claust/robot_3d/shared/RobotLink/README.md

# RobotLink

The Bluetooth side of the robot car remote ([ios/RobotRemote](../../ios/RobotRemote)):

| | |
|---|---|
| `DriveProtocol` | the GATT contract with [pi/robot_car/remote.py](../../pi/robot_car/remote.py): UUIDs, rate, the 4-byte command |
| `WheelSpeeds` | signed wheel speeds, and `arcade(x:y:)`, the one-thumb stick-to-wheels mix |
| `DrivePattern` | the preset square, circle and eight as timed wheel commands, from the car's track and a fitted command-to-speed model, with a correction per kind of move |
| `CarLink` | what the UI holds: the link's state and signal strength, `wheels` and `cutter` to set, which only count while connected, and `drive(_:)` to play a pattern until it ends, is stopped, the wheels are set by hand or the link drops; `simulated` for the iOS Simulator |
| `LinkMachine` | the connection logic as a pure state machine: scan, connect, find the drive service, time out, search again (internal) |
| `Radio` | CoreBluetooth on its own serial queue, running `LinkMachine`'s effects and the 20 Hz command stream off the main thread (internal) |

No UI, and declared for macOS 14 as well as iOS 17, so the mix, the
encoding, the patterns and the connection logic are unit-tested on the Mac.
The pattern tests run each pattern through the timing's own model and check
the path in centimetres:

```sh
swift test --package-path shared/RobotLink
```
