claust/robot_3d/ios/RobotRemote/README.md

# Robot Remote (iOS)

Drives the robot car from an iPhone over Bluetooth LE, one thumb on a
floating stick. Wherever the thumb lands in the bottom panel becomes the
centre. Up drives both wheels forward, down both back, sideways spins the car
on the spot, and anything between is an arc. Lifting the thumb stops the car,
and so does losing the link: after a reconnect the car waits for the thumb to
move again rather than resuming the old command.
The two bars show what each wheel is being told, and "Top speed" caps both.

## Patterns

Above the stick, three buttons drive a preset route on their own: **Square**
(40 cm sides, turning left on the spot at each corner), **Circle** (40 cm
across, to the left) and **Eight** (a 40 cm loop to the left, a short pause,
then one to the right, meeting where the car started). Each ends where it
began. Give it a clear patch of floor about a metre across, with the car in
the middle. While a pattern runs, the row shows its progress and a Stop button.
Dragging the stick also takes over. Losing the link ends the pattern, and it
doesn't resume after a reconnect. Patterns run at their own fixed speeds,
whatever "Top speed" says, so a calibration stays valid.

The car has no wheel sensors, so the app times each move from the car's
geometry and a model of how fast a wheel rolls for a given command. Any
command lifts the motors to their 25 % starting duty, which already rolls
the car at about a third of its top speed, so the model has a floor and the
circle's inner wheel gets less than its share of the command. The slider
button next to the patterns corrects the model, one setting per kind of
move:

- **Straight**: if the square's sides come out at 36 cm instead of 40,
  raise it to about 40 / 36 = 111 %.
- **Corners**: lower it if the corners turn more than 90°, raise it if less.
- **Circle size**: lower it if the circle comes out wider than 40 cm. It
  changes the wheels' speeds, not the time, and usually fixes how far round
  the circle goes as well, so set it first.
- **Circle length**: raise it if the circle then stops short of where it
  started, lower it if it goes past.

Expect a few degrees of scatter from run to run: each command reaches the
car on the next 20 Hz tick, and some arrive a tick late over Bluetooth. The
timing is in `DrivePattern` in [shared/RobotLink](../../shared/RobotLink).

The first time, switch the car on and open the app within two minutes:
iOS asks to pair, and you tap Pair. The car only takes commands from a
paired phone, and only pairs new phones just after power-on. See
[Pairing a phone](../../pi/robot_car/README.md#pairing-a-phone).

With VoiceOver, Voice Control or Switch Control the stick is one
adjustable control named Drive. Swipe up or down to step the speed by a
quarter, use its actions to turn left, turn right, go straight or stop,
or stop with the escape or magic-tap gesture. That command holds until it
is changed, and stops when the app leaves the screen.

The app connects to the first car advertising the drive service and goes
back to scanning when the link drops. When the app leaves the screen it lets
go of the car. It keeps the screen awake while connected. The Bluetooth
logic is in [shared/RobotLink](../../shared/RobotLink). The car's end,
including the 300 ms watchdog that stops the wheels when the phone goes
quiet, is [pi/robot_car/remote.py](../../pi/robot_car/remote.py).

## Build and install on the phone

The Simulator has no Bluetooth, so the real thing needs the phone, plugged in
or on the same network with developer mode on. Requires Xcode and
[XcodeGen](https://github.com/yonaskolb/XcodeGen); the `.xcodeproj` is
generated, not committed. `xcrun devicectl list devices` gives the phone's
identifier.

```sh
xcodegen generate
xcodebuild -project RobotRemote.xcodeproj -scheme RobotRemote \
  -destination "id=$PHONE" -derivedDataPath build \
  -allowProvisioningUpdates DEVELOPMENT_TEAM=$TEAM build
xcrun devicectl device install app --device "$PHONE" build/Build/Products/Debug-iphoneos/RobotRemote.app
xcrun devicectl device process launch --device "$PHONE" dk.delectosoft.robotremote
```

The first launch asks for Bluetooth permission.

## Simulator

In the Simulator the app drives a simulated car, which connects after a
moment and shows the stick and wheel bars working. Launching on the phone
with `--simulate` does the same.

```sh
xcodebuild -project RobotRemote.xcodeproj -scheme RobotRemote \
  -sdk iphonesimulator -destination 'name=iPhone 17 Pro' \
  -derivedDataPath build build
xcrun simctl install booted build/Build/Products/Debug-iphonesimulator/RobotRemote.app
xcrun simctl launch booted dk.delectosoft.robotremote
```
