claust/robot_3d/shared/BambuKit/README.md

# BambuKit

The protocol layer both status apps build on — the macOS window app
(`macos/PrinterStatus`) and its iPhone sibling (`ios/PrinterStatus`) each
depend on this package, so a protocol fix lands in both at once.

| | |
|---|---|
| `BambuMQTTSource` | LAN MQTT session: subscribe, `pushall`, reconnect forever |
| `BambuTrust` | Bambu's device-CA roots, vendored from Bambu Studio (internal) |
| `BambuCameraSource` | chamber camera: RTSPS → H.264 → VideoToolbox, emitting `CGImage` |
| `BambuDeviceCA` | harvests the intermediate CA the camera port omits |
| `PrinterSnapshot` | tolerant decode of one `print` report, plus `deepMerge` |
| `PrinterConfig` | the three credentials; each app resolves them its own way |
| `PrinterDiscovery` / `DiscoveredPrinter` | find printers on the LAN by unicast M-SEARCH sweep; the `SSDP` wire format and probe behind it are internal |
| `PrinterNameSource` | the single-host case: the friendly name for a known IP |
| `SimulatedSource` | fake reports in the printer's own schema |

No UI. The package is declared for both macOS 14 and iOS 17, so an
accidental `import AppKit` fails here rather than in one app's build. That is
also why the camera emits `CGImage` rather than `NSImage`/`UIImage`.

RTSP comes from [claust/IPCamKit](https://github.com/claust/IPCamKit), our
fork of [steelbrain/IPCamKit](https://github.com/steelbrain/IPCamKit) (MIT),
pinned by revision. The fork exists for two patches upstream lacks — TLS, and
a Digest quirk that Bambu's LIVE555 server rejects — both described in that
repo's `PATCHES.md`.

```sh
swift build --package-path shared/BambuKit
swift test --package-path shared/BambuKit   # SSDP parsing + subnet arithmetic
```

Discovery notes, including why it sweeps unicast instead of listening for
Bambu's broadcasts, are in [../../macos/RESEARCH.md](../../macos/RESEARCH.md)
and the doc comment on `PrinterDiscovery`.
