claust/robot_3d/macos/RESEARCH.md

# Printer status data — research notes

What the Bambu Lab X2D exposes over the LAN, measured live against our printer
(2026-08-26, firmware ota 01.02.00.00, mid-print of `fit_test_02`) plus the
community docs (OpenBambuAPI, ha-bambulab/pybambu).

## Transport

- MQTT over TLS on port 8883, user `bblp` + LAN access code (same credentials
  as `cad/.env`). The printer's certificate is not publicly trusted: it
  chains to Bambu's own device CA (root shipped with Bambu Studio, vendored
  in `PrinterStatus/Sources/PrinterStatus/BambuTrust.swift`), and names the
  printer's serial rather than its IP.
- Subscribe to `device/<SERIAL>/report`. After one
  `{"pushing": {"command": "pushall"}}` request the X2D pushes a **full ~99-key
  report about once per second while printing** — no polling loop needed.
  When idle the push rate drops; send a `pushall` on reconnect and every few
  minutes as a keepalive refresh.
- Same MQTT channel accepts commands (`device/<SERIAL>/request`): pause /
  resume / stop, speed level, lights, target temps, AMS ops.

## Available fields (measured — `print.*` unless noted)

### Job & progress
| Field | Example | Meaning |
|---|---|---|
| `gcode_state` | `RUNNING` | IDLE / INIT / PREPARE / SLICING / RUNNING / PAUSE / FINISH / FAILED / OFFLINE |
| `subtask_name` | `fit_test_02` | job name |
| `gcode_file` | `/data/Metadata/plate_1.gcode` | file being printed |
| `mc_percent` | `92` | progress % |
| `layer_num` / `total_layer_num` | `37` / `45` | current / total layer |
| `mc_remaining_time` | `0` | minutes remaining |
| `mc_print_stage`, `stg_cur` | `2`, `0` | stage codes — `stg_cur`: 0 printing, 1 bed leveling, 2 bed preheat, 7 heating hotend, 10 first-layer inspect, 13 homing, 16 paused-by-user, 24 filament loading … (pybambu const.py `CURRENT_STAGE_IDS`; -1/255 = idle) |
| `print_error`, `mc_print_error_code` | `0` | error codes |
| `hms` | `[{attr, code, …}]` | active HMS health warnings; hex words of attr+code form the wiki code, e.g. `wiki.bambulab.com/en/x1/troubleshooting/hmscode/0300_0100_0001_0007` |

### Temperatures
| Field | Example | Meaning |
|---|---|---|
| `nozzle_temper` / `nozzle_target_temper` | `220.0` / `220.0` | **active** nozzle |
| `bed_temper` / `bed_target_temper` | `55.0` / `55.0` | bed |
| `device.extruder.info[i].temp` | `14418140` | per-nozzle, bit-packed: low 16 bits = current, high 16 = target (14418140 = 220/220 °C) |
| `device.bed.info.temp` | `3604535` | packed the same way (55/55 °C) |
| `device.ctc.info.temp` | `32` | chamber, packed the same way (heater off → target 0) |

The packed `device.*` fields are the only place both nozzles appear; the flat
`nozzle_temper` tracks whichever nozzle is active. Per pybambu: extruder
**id 0 = right, id 1 = left**; the active extruder index is
`(device.extruder.state >> 4) & 0xF` (low 4 bits = extruder count). Our
capture: `state = 0x8112` → 2 extruders, left one active at 220 °C while the
right sat at 41 °C. `info[i].snow` says which AMS slot feeds each nozzle
(low bits = tray, `>>8` = AMS unit; 255 = none, 254 = external spool).
If `device` is absent (older firmware), fall back to the flat fields.

### Fans, speed, environment
- `cooling_fan_speed`, `big_fan1_speed` (aux), `big_fan2_speed` (chamber),
  `heatbreak_fan_speed` — raw 0–15 PWM as strings; percent ≈ `v * 100 / 15`.
- `device.airduct.parts[]` — X2D's real fan/airduct percentages (`state`/`tar_state`).
- `spd_lvl` (1 silent / 2 standard / 3 sport / 4 ludicrous), `spd_mag` (%).
- `wifi_signal` (`-58dBm`), `lights_report` (chamber/work light on/off),
  `sdcard`, `xcam` (spaghetti detection etc. settings + `printing_monitor`).

### AMS (`ams.ams[]`)
Per unit: `humidity` (bucket 1–5), `humidity_raw` (%), `temp` (°C),
`dry_time`/`dry_setting` (drying state on AMS 2 Pro/HT), and per tray:
`tray_type` (PLA…), `tray_sub_brands`, `tray_color` (RRGGBBAA hex),
`remain` (%), `tray_info_idx` (profile code, GFA00 = Bambu PLA Basic),
nozzle temp range. An empty slot sends just `{"id": …}`. Matches our 4 slots
(black/white/blue/green). On dual-nozzle printers the active tray per nozzle
comes from `device.extruder.info[].snow`, not the classic `tray_now`.

### Hardware info (`device.nozzle`, `info.module[]`)
Both nozzles' `diameter` (0.4), `type` (HS01), `wear`; firmware versions per
module via `{"info": {"command": "get_version"}}`.

### Camera
`ipcam.rtsp_url` = `rtsps://<printer-ip>:322/streaming/live/1` — 1080p chamber
live view (user `bblp` + access code). The field reads `"disable"` if "LAN
Mode Liveview" is toggled off on the touchscreen — ours has it enabled.

Measured against our X2D while building `BambuCameraSource` (2026-09-01):

- **RTSP over TLS, LIVE555 server.** The request URI must use the `rtsps://`
  scheme — an `rtsp://` URI gets a `301` to `rtsps://<ip>/1`. Default port is
  322. Auth is **Digest MD5**; the server issues a fresh nonce per 401, so a
  client must re-read `WWW-Authenticate` each time rather than reuse one.
- **`algorithm=MD5` breaks it.** A Digest response carrying the (optional,
  RFC 7616) `algorithm` parameter is rejected even when the hash is correct.
  Two requests differing only in that parameter: `plain -> 200 OK`,
  `algorithm -> 401 Unauthorized`. Send it only when the challenge named one.
- **Transport:** `RTP/AVP/TCP;interleaved=0-1` works, so RTP rides the same
  TLS socket — no UDP, no second port. ~250 KB/s (2 Mbit/s).
- **Video:** H.264 High 4.1, `packetization-mode=1`, 1920x1080. NAL types seen
  are 28 (FU-A), 7 (SPS) and 8 (PPS) — parameter sets repeat in-band roughly
  once a second, and also arrive up front in the SDP's `sprop-parameter-sets`.
- **The two TLS ports present different chains:**

  | Port | Chain sent |
  |---|---|
  | 8883 (MQTT) | leaf `CN=<serial>` + intermediate `BBL Device CA N6-V2` |
  | 322 (RTSPS) | leaf only |

  So the camera port alone cannot be verified — `Unable to build chain to
  root (possible missing intermediate)` — which is why other tools disable
  verification or pin a bare fingerprint. `BambuDeviceCA` instead harvests
  the intermediate from a TLS-handshake-only connection to 8883 (no MQTT
  packet is sent) and adds it as an anchor; the harvested chain must itself
  validate against the pinned roots first, so a rogue 8883 cannot inject an
  anchor. The device CA is issued by `BBL CA2 RSA` and runs to 2040.
- **Hostname verification must be off, and the SSL policy avoided entirely.**
  Under `SecPolicyCreateSSL` the leaf fails three ways: `SSL hostname does not
  match name(s) in certificate`, `Certificate exceeds maximum temporal
  validity period` (Apple's 398-day cap), and `Extended key usage does not
  match certificate usage`. `SecPolicyCreateBasicX509` verifies the signature
  chain without those, which is what the camera uses on both platforms.
- Port 6000 (the legacy P1/A1 chamber-JPEG protocol) is open on the X2D but
  answers the auth packet with an 8-byte `ffffffff…` error and closes. No
  JPEG-stills shortcut here.

## Commands (topic `device/<SERIAL>/request`)

- `{"print": {"command": "pause" | "resume" | "stop", "param": ""}}`
- `{"print": {"command": "print_speed", "param": "1".."4"}}` (silent→ludicrous)
- `{"system": {"command": "ledctrl", "led_node": "chamber_light", "led_mode": "on"|"off"}}`
- `{"print": {"command": "gcode_line", "param": "M104 S220\n"}}` — temps via
  gcode: M104 nozzle, M140 bed, M141 chamber
- `{"pushing": {"command": "pushall"}}`, `{"info": {"command": "get_version"}}`
- AMS: `ams_control`, `ams_change_filament`, `ams_filament_drying`, …
- Caveat: newest firmware gates *some* control commands behind an "MQTT
  signature" in LAN mode; status reads are unaffected.

## Device name / SSDP discovery

The user-assigned printer name ("Claudia") is NOT in the MQTT report. It is
carried in SSDP headers: the printer broadcasts NOTIFY announcements to
255.255.255.255 UDP port 2021 every ~5 s with `DevName.bambu.com`,
`DevModel.bambu.com` (X2D reports `N6`) and `DevVersion.bambu.com` headers.

Do not listen passively on 2021: with SO_REUSEPORT the kernel delivers each
broadcast to only ONE of the sockets bound to the port, so Bambu Studio (or a
second app instance) starves the listener indefinitely — observed live.
Instead send a directed M-SEARCH (`ST: urn:bambulab-com:device:3dprinter:1`)
to the printer on UDP 1990 or 2021; it replies unicast to the sender's
ephemeral port immediately, no port sharing involved
(`shared/BambuKit/Sources/BambuKit/SSDP.swift`).

The unicast reply carries everything needed to configure a printer except
the access code — `USN` is the serial, plus `DevName`/`DevModel`/`DevVersion`
(and `DevConnect: lan`, `DevBind: free`). So *discovery* is the same request
sent to every address on the subnet: 254 hosts × 2 ports left this Mac in
10 ms and the printer answered in 130 ms (`PrinterDiscovery.swift`, or
`swift run PrinterStatus --discover`). Pace the sends — a phone that dumps
hundreds of datagrams at an empty ARP table gets ENOBUFS and silently loses
most of them.

Sweeping unicast rather than listening for the broadcast is not only about
SO_REUSEPORT: on iOS, broadcast and multicast both require the
`com.apple.developer.networking.multicast` entitlement, which Apple grants
by application only. Unicast to LAN addresses needs just the ordinary Local
Network permission. Neither platform exposes an API for reading that grant,
so a refusal and an empty network look identical — a sweep that finds
nothing has to offer both explanations.

Bambu printers advertise nothing over Bonjour/mDNS (browsed
`_services._dns-sd._udp`, August 2026), so SSDP is the only discovery
channel.

## Sources

- Live capture: `pushall` dump against our X2D (see `cad/printer_status.py`).
- https://github.com/Doridian/OpenBambuAPI/blob/main/mqtt.md (also video.md,
  ftp.md — FTPS port 990 implicit TLS).
- https://github.com/greghesp/ha-bambulab — pybambu `models.py` / `const.py` /
  `commands.py`: field decoding incl. H2D/X2D dual-nozzle handling.
