claust/robot_3d/esp32-c5/blink/blink_schematic.png

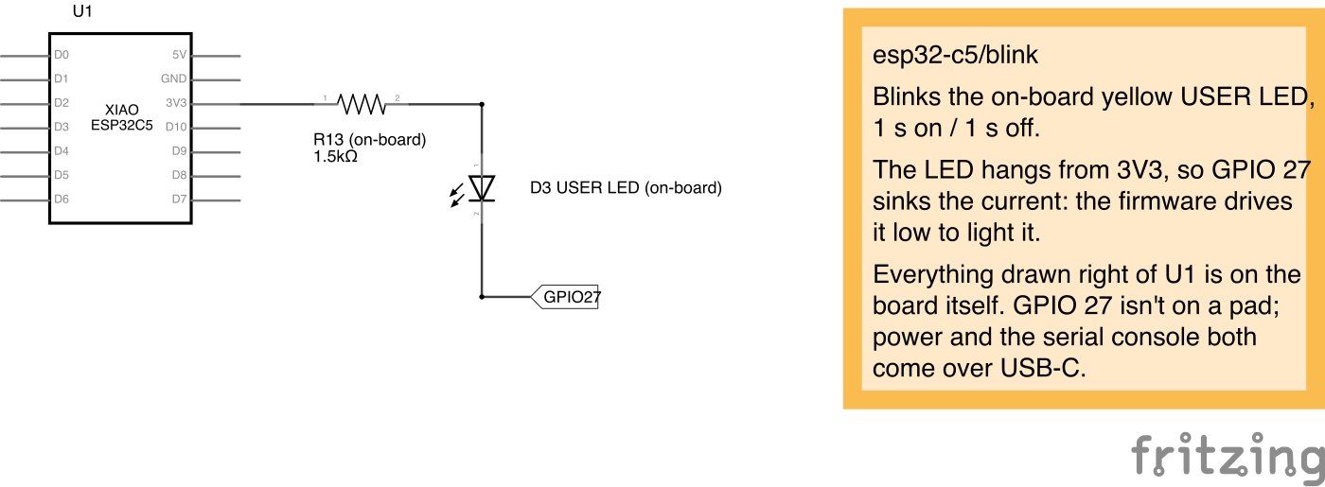
esp32-c5/blink/blink_schematic.png
