claust/robot_3d/esp32-c5/led_flash/led_flash_schematic.png

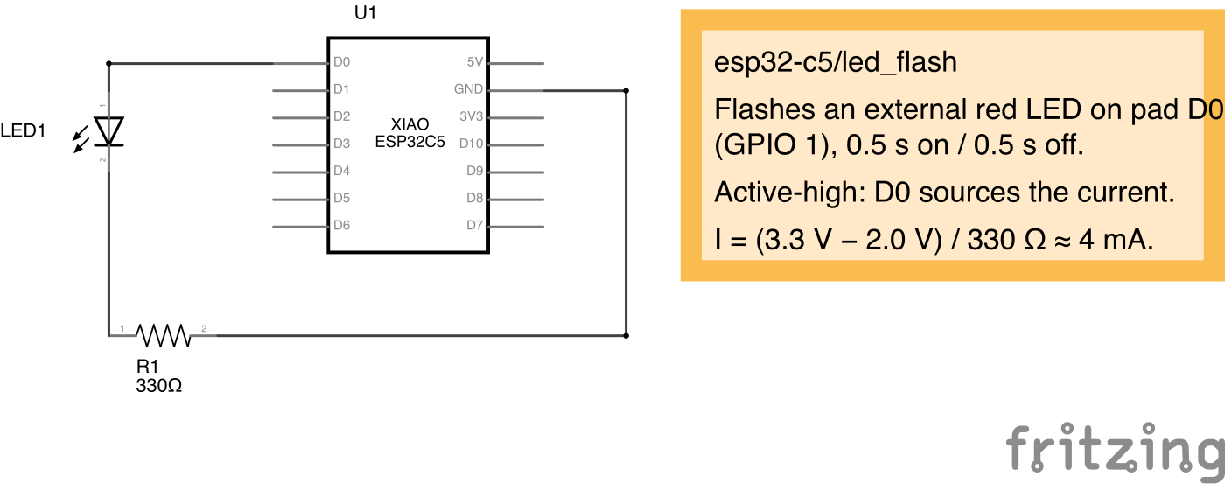
esp32-c5/led_flash/led_flash_schematic.png
