claust/robot_3d/parts/photos/c3-xiao-esp32c5-pinout-back.png

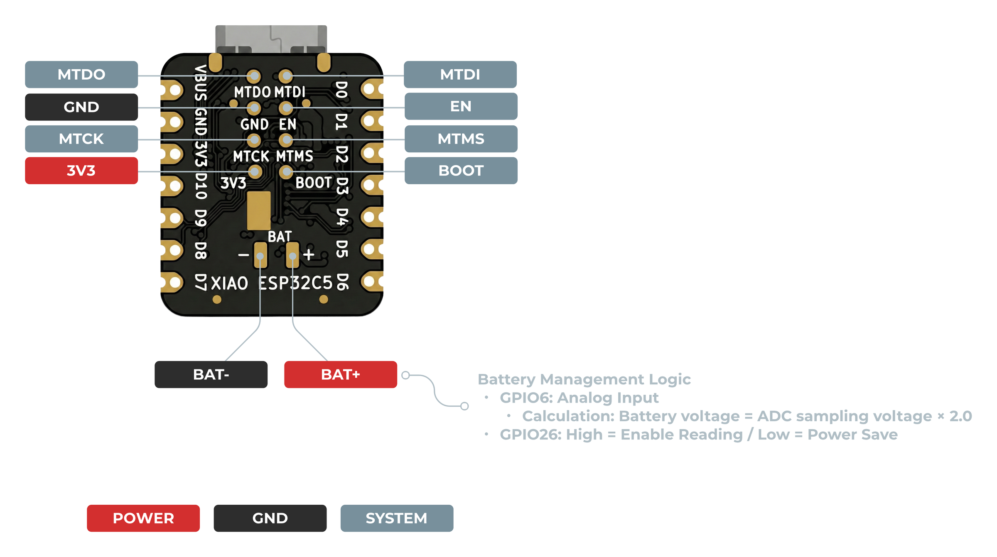
parts/photos/c3-xiao-esp32c5-pinout-back.png
