claust/robot_3d/parts/photos/d2-drv8833-pinout.jpg

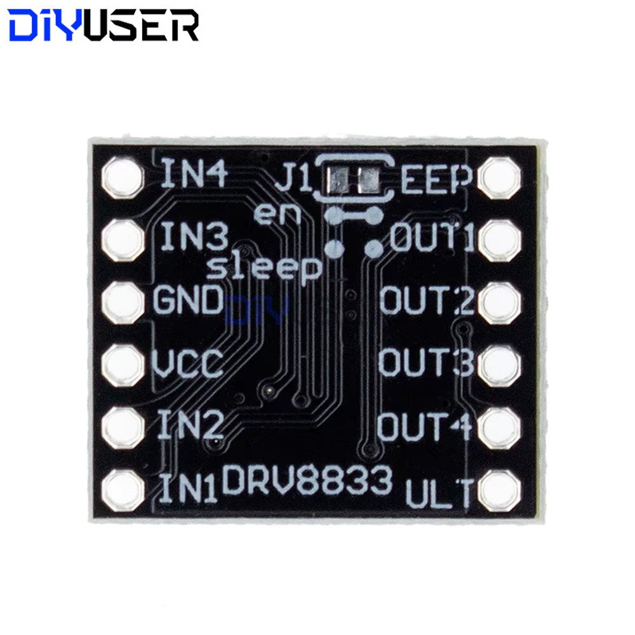
parts/photos/d2-drv8833-pinout.jpg
