claust/robot_3d/parts/photos/d3-drv8833-realpoy-spec.jpg

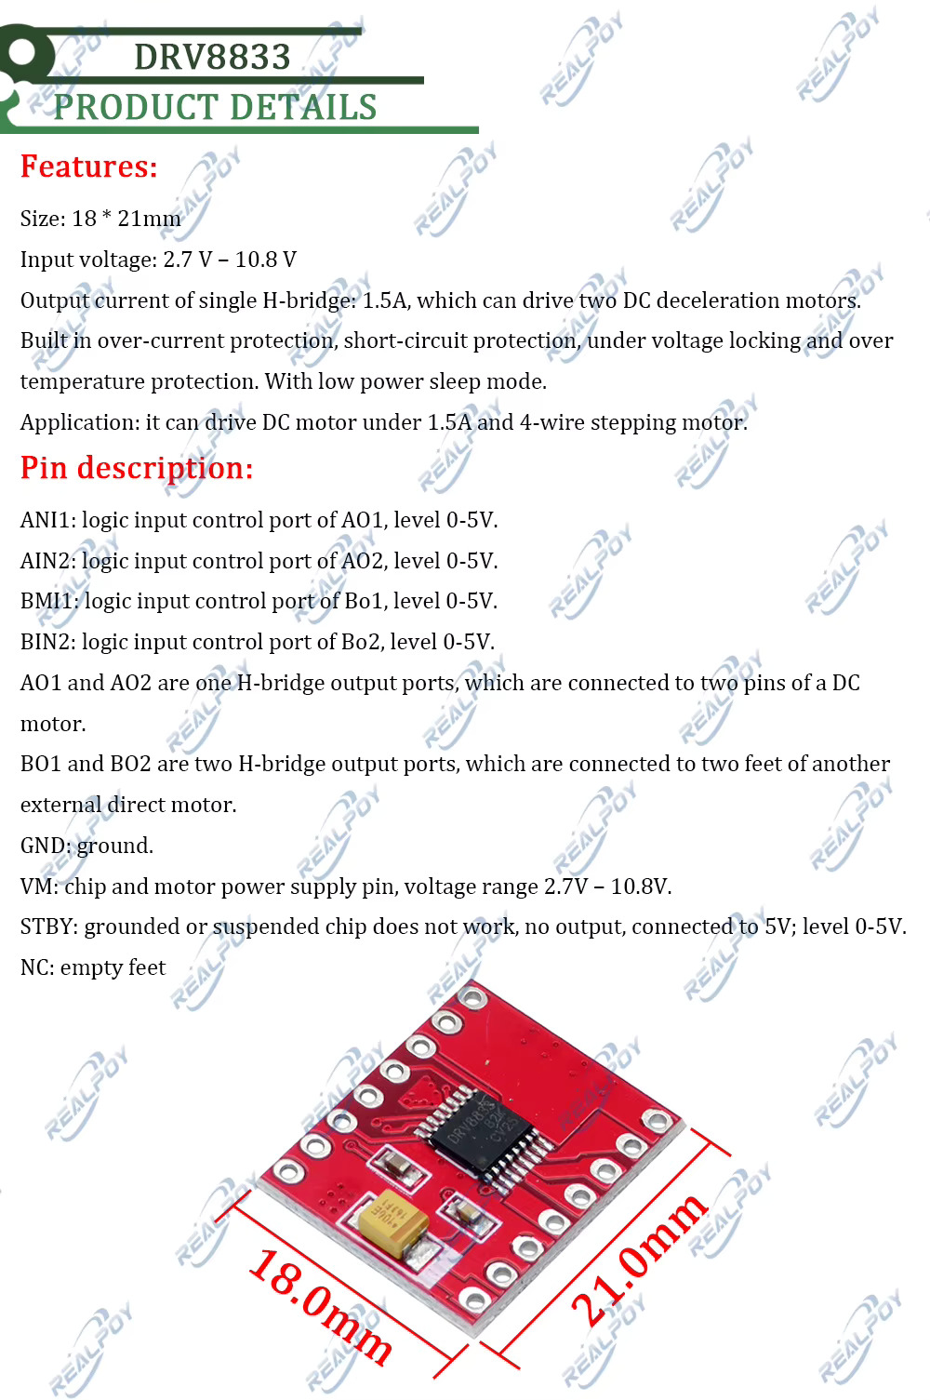
parts/photos/d3-drv8833-realpoy-spec.jpg
