claust/robot_3d/parts/photos/d4-tb6612-spec.jpg

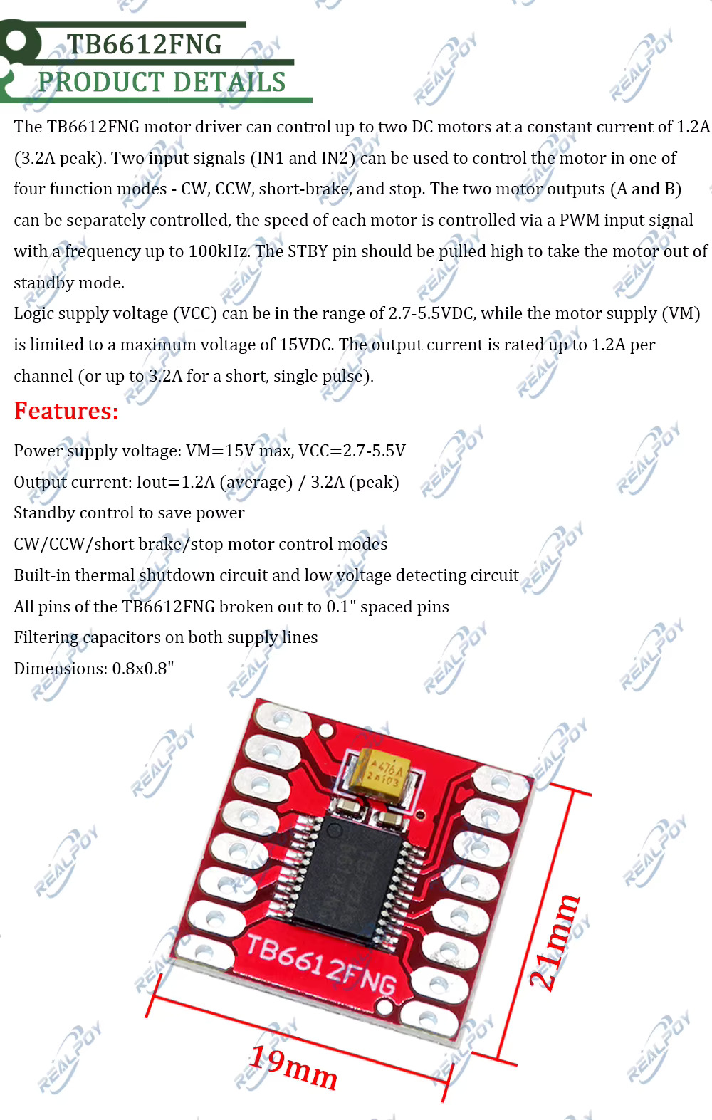
parts/photos/d4-tb6612-spec.jpg
