claust/robot_3d/parts/photos/p1-mp1584-pinout.jpg

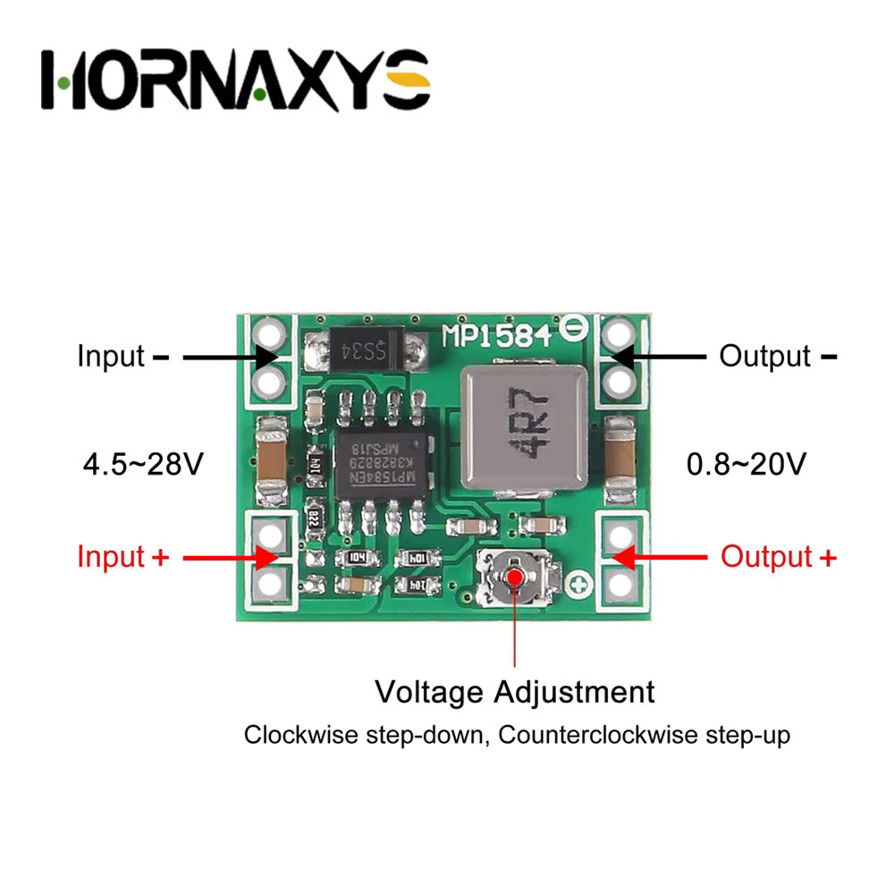
parts/photos/p1-mp1584-pinout.jpg
