claust/robot_3d/parts/photos/b2-yowoo-lipo.jpg

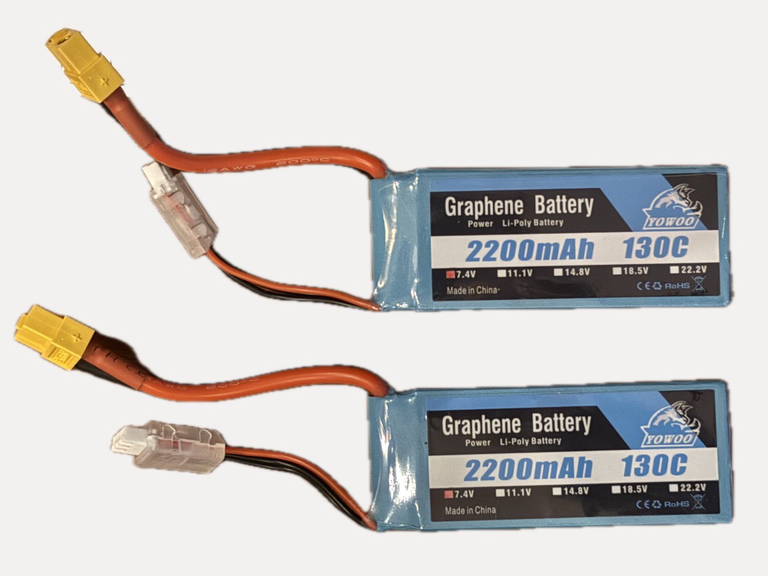
parts/photos/b2-yowoo-lipo.jpg
