claust/robot_3d/parts/photos/c1-pi-zero-2w-top.jpg

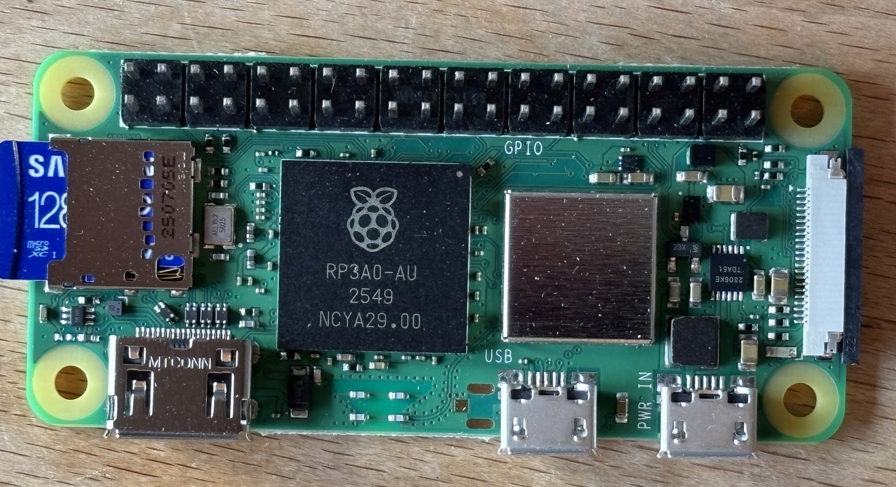
parts/photos/c1-pi-zero-2w-top.jpg
