claust/robot_3d/parts/photos/c2-uno-breadboard.jpg

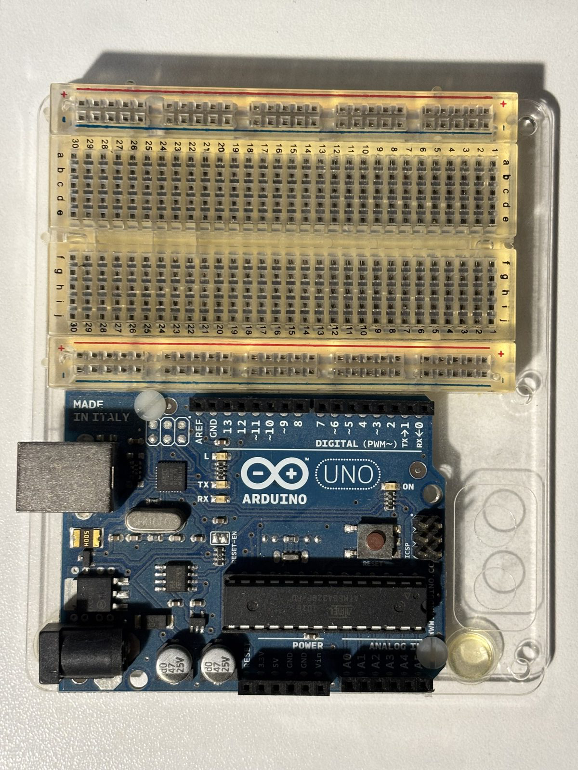
parts/photos/c2-uno-breadboard.jpg
