claust/robot_3d/parts/photos/d2-drv8833-back.jpg

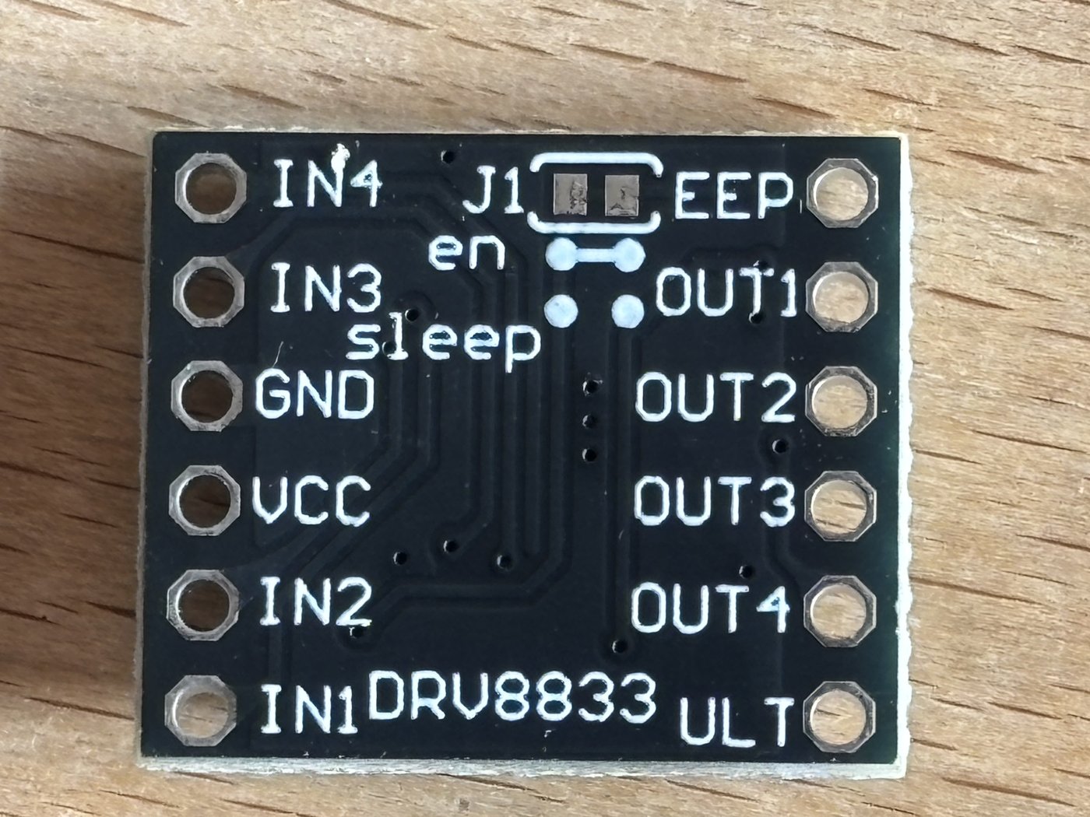
parts/photos/d2-drv8833-back.jpg
