claust/robot_3d/parts/photos/d2-drv8833-chip.jpg

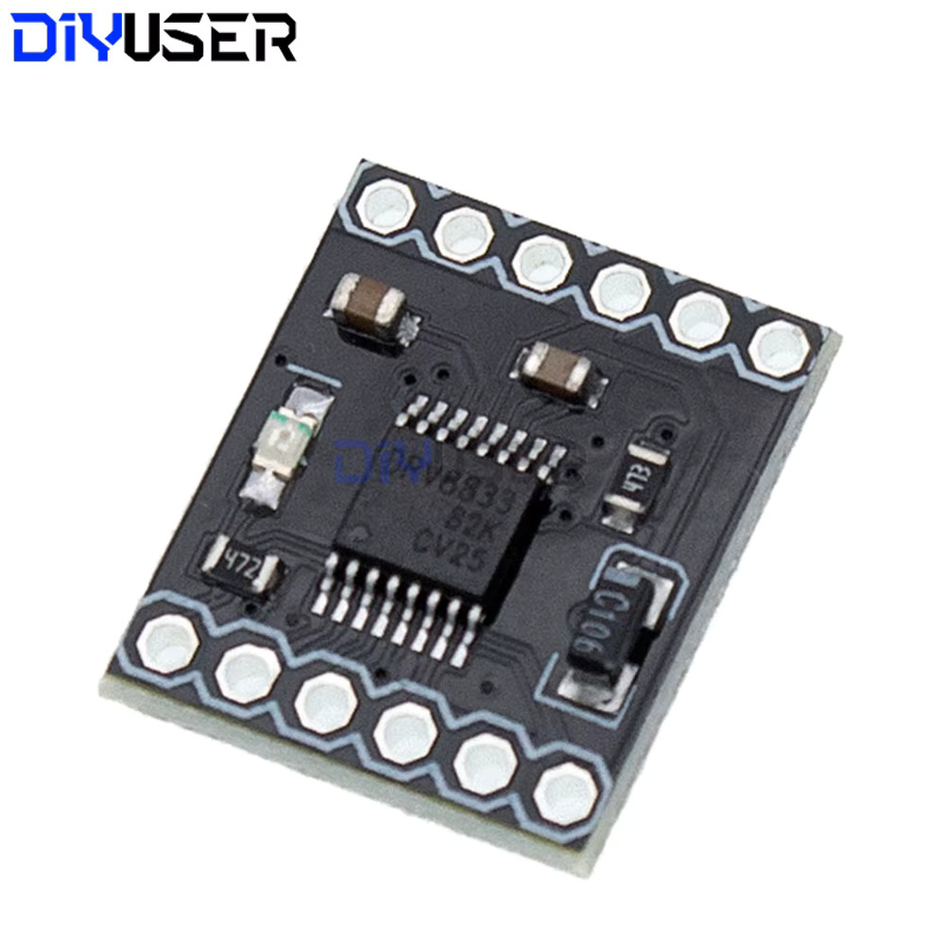
parts/photos/d2-drv8833-chip.jpg
