claust/robot_3d/parts/photos/l1-1388-front.jpg

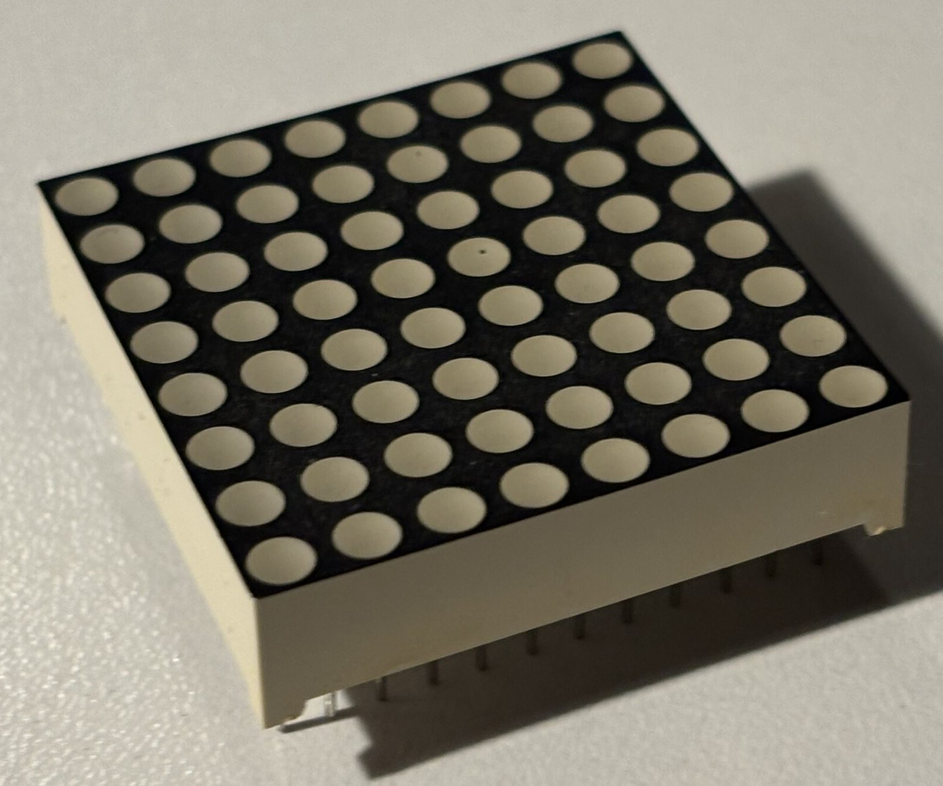
parts/photos/l1-1388-front.jpg
