claust/robot_3d/parts/photos/l1-1388-marking.jpg

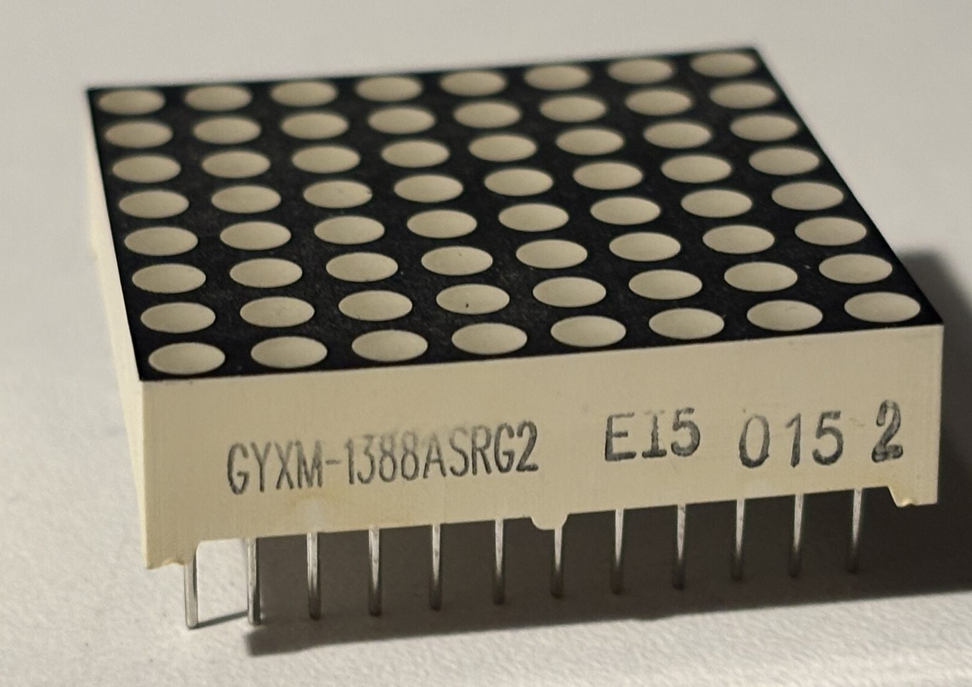
parts/photos/l1-1388-marking.jpg
