claust/robot_3d/parts/photos/m1-ck35-model.png

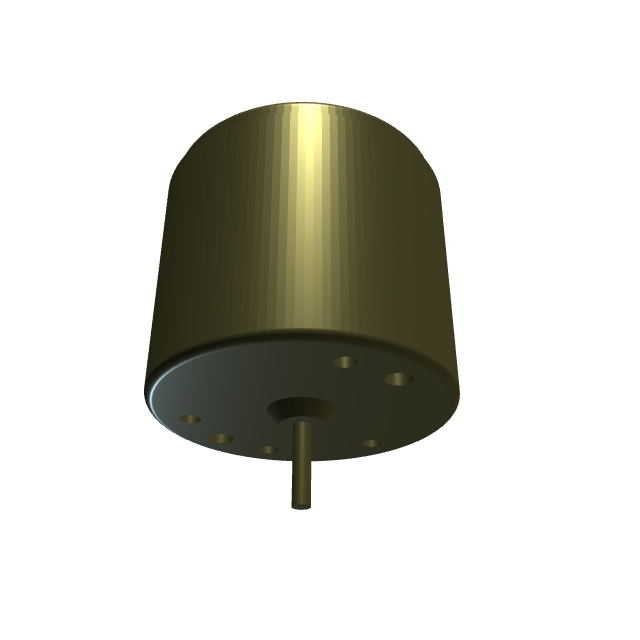
parts/photos/m1-ck35-model.png
