claust/robot_3d/parts/photos/m1-ck35-motor.jpg

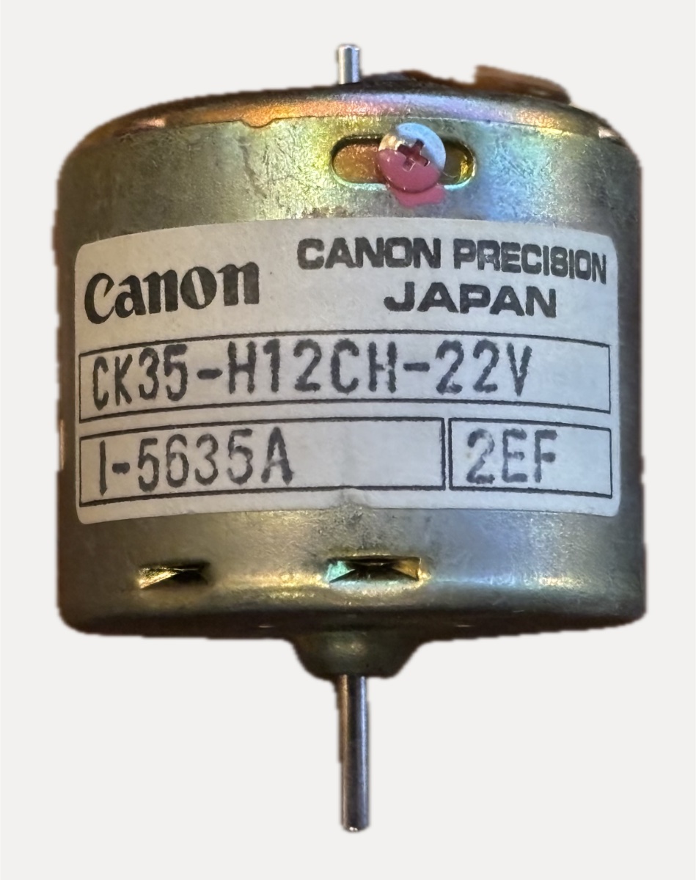
parts/photos/m1-ck35-motor.jpg
