claust/robot_3d/parts/photos/m2-n20-dimensions.png

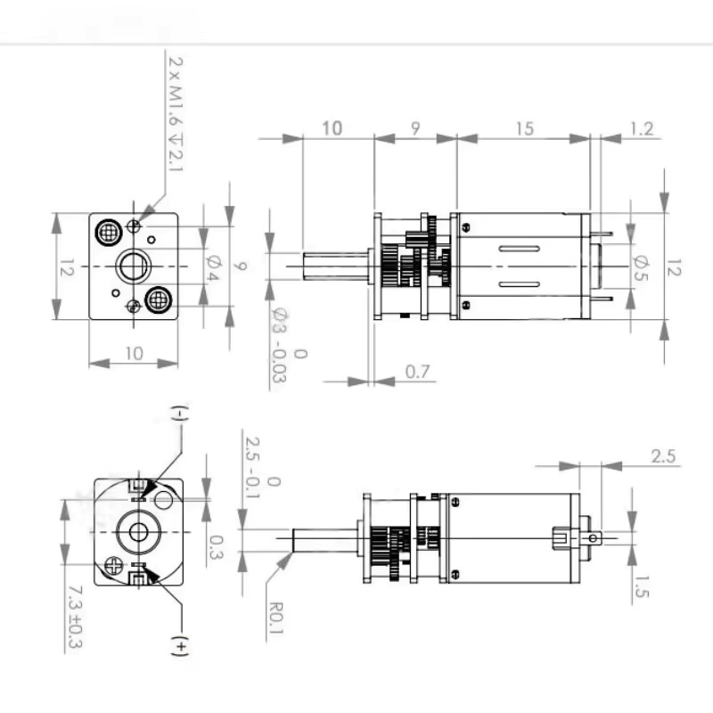
parts/photos/m2-n20-dimensions.png
