claust/robot_3d/parts/photos/m2-n20-model.png

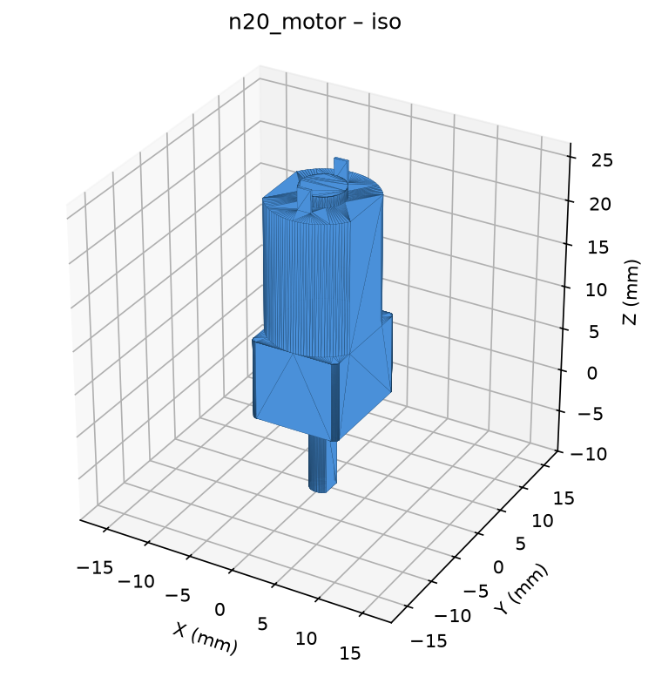
parts/photos/m2-n20-model.png
