claust/robot_3d/parts/photos/m2-n20-param-table.jpg

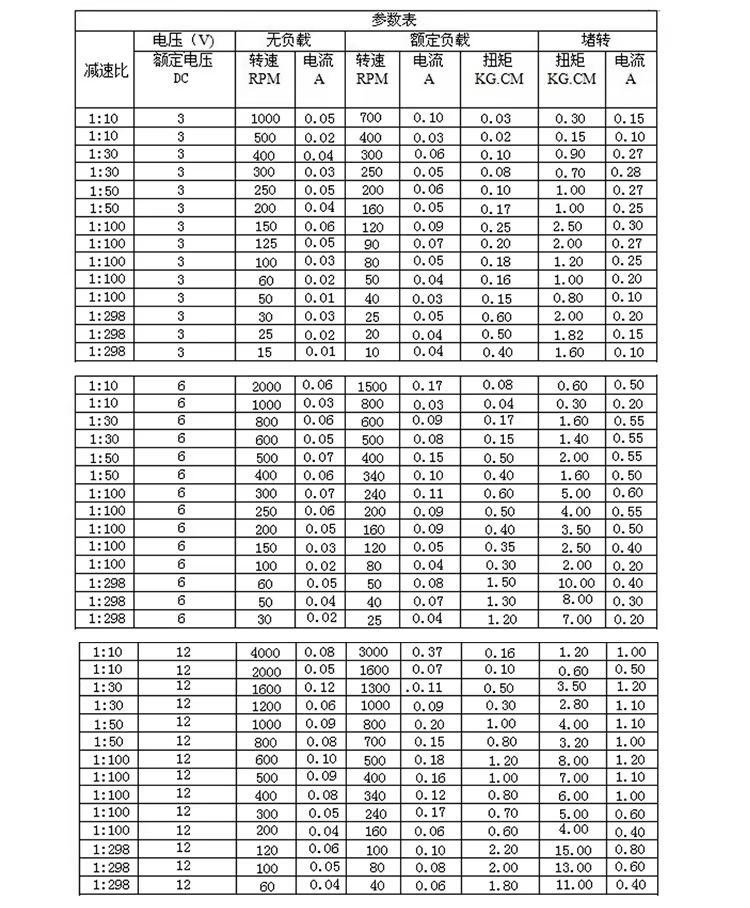
parts/photos/m2-n20-param-table.jpg
