claust/robot_3d/parts/photos/m2-n20-product.jpg

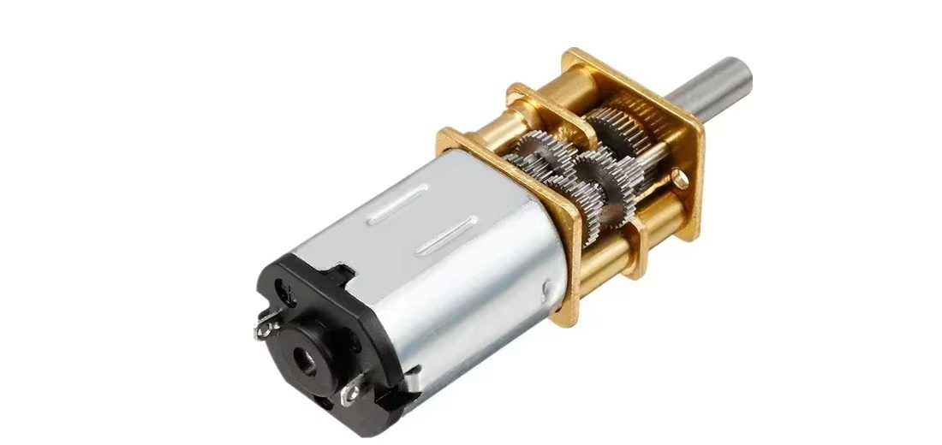
parts/photos/m2-n20-product.jpg
