claust/robot_3d/parts/photos/m2-n20-terminals.jpg

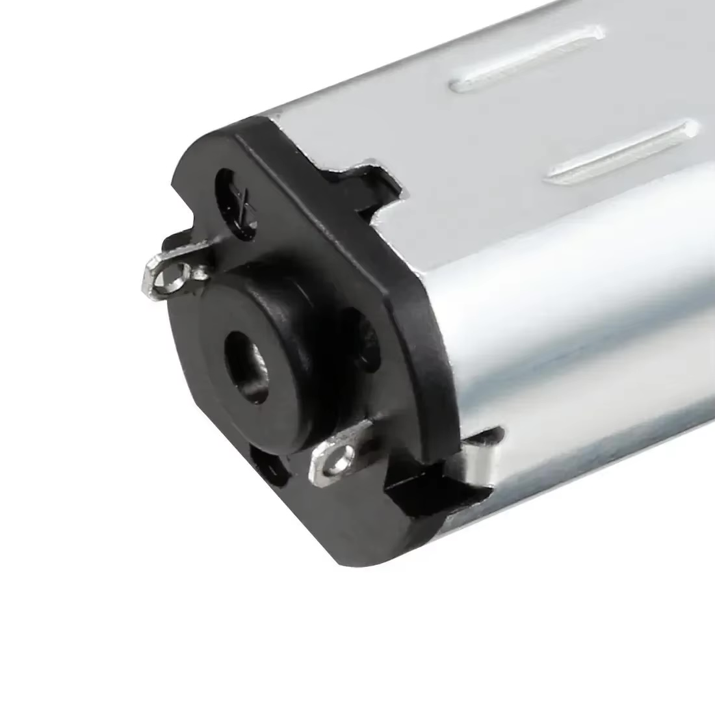
parts/photos/m2-n20-terminals.jpg
