claust/robot_3d/parts/photos/p1-mp1584-back.jpg

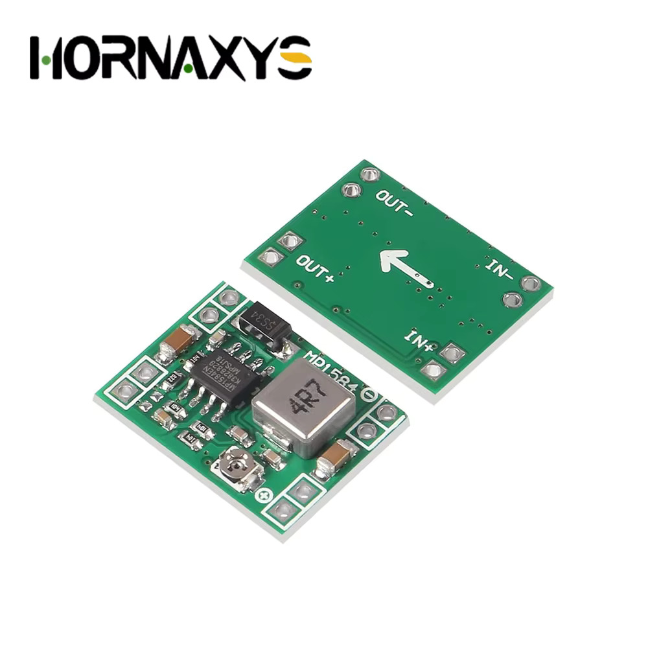
parts/photos/p1-mp1584-back.jpg
