claust/robot_3d/parts/photos/p1-mp1584-dimensions.jpg

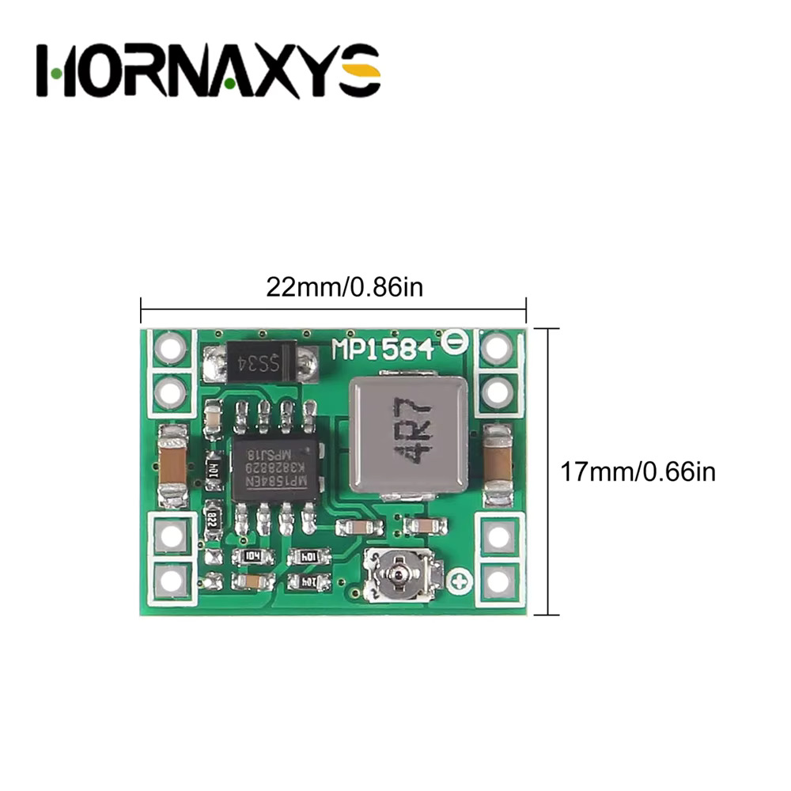
parts/photos/p1-mp1584-dimensions.jpg
