claust/robot_3d/parts/photos/r1-cm02-bottom.jpg

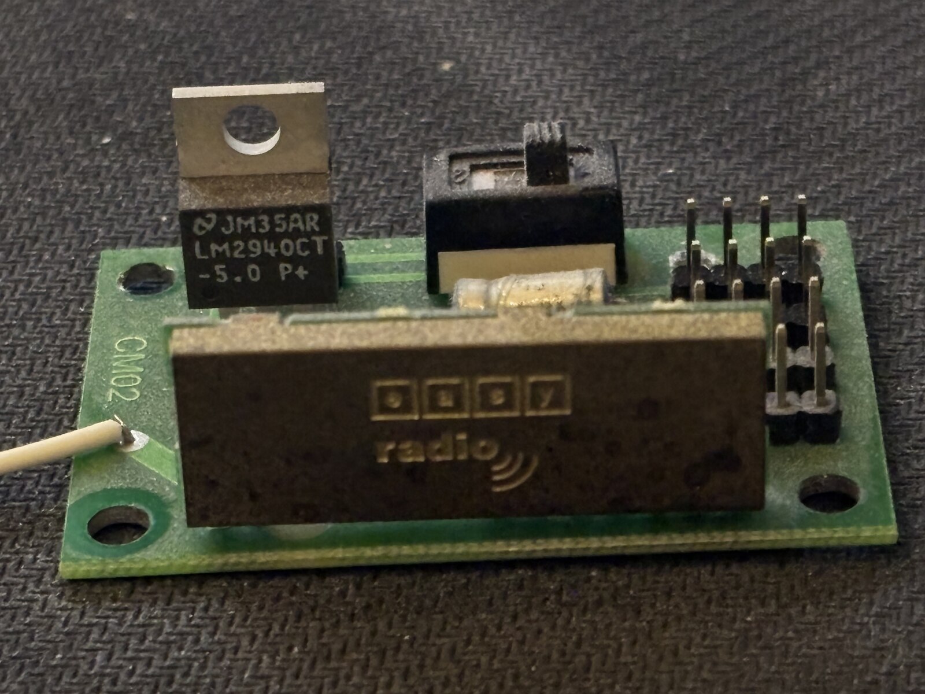
parts/photos/r1-cm02-bottom.jpg
