claust/robot_3d/parts/photos/r1-cm02-top.jpg

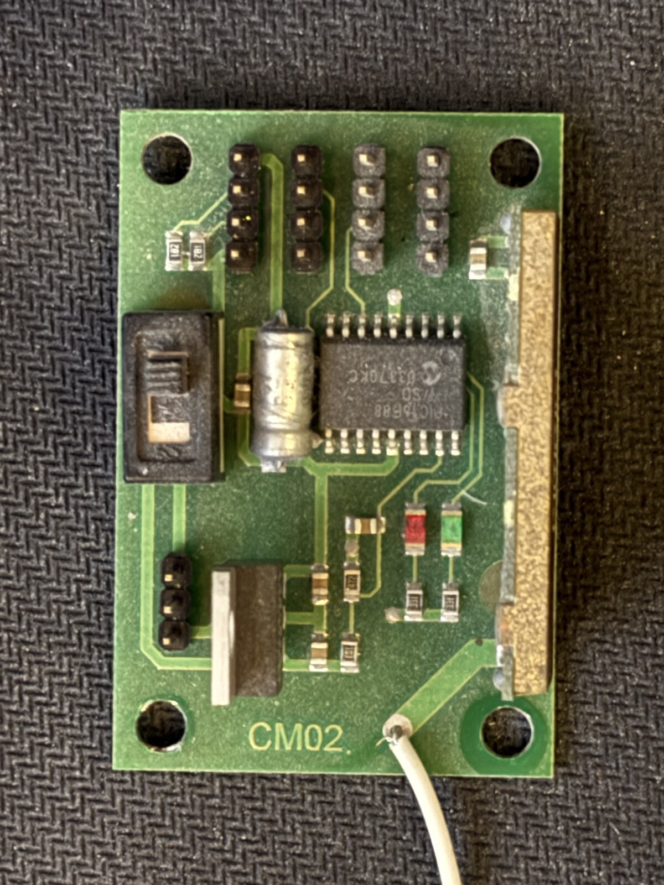
parts/photos/r1-cm02-top.jpg
