claust/robot_3d/parts/photos/s1-srf08-back.jpg

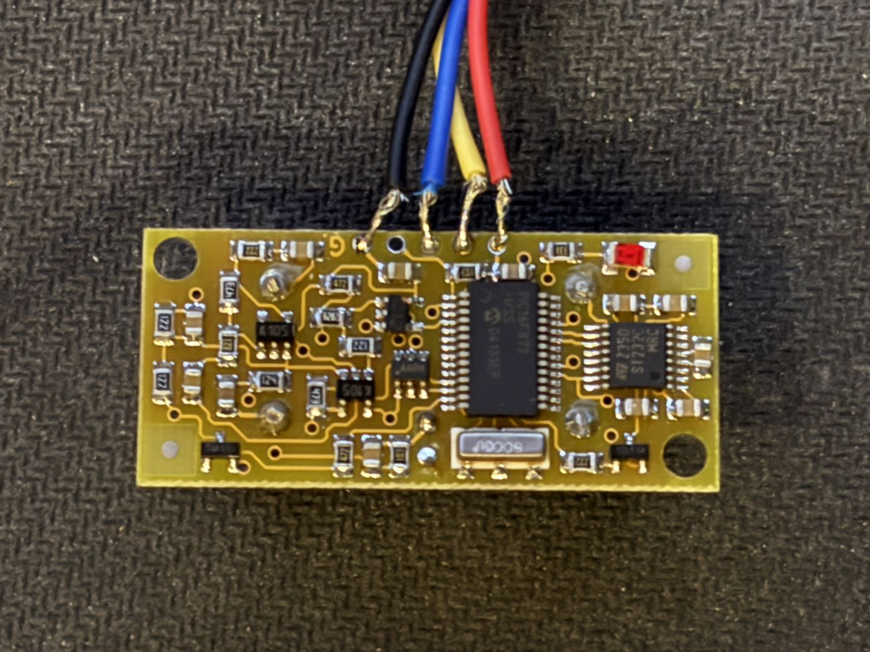
parts/photos/s1-srf08-back.jpg
