claust/robot_3d/parts/photos/s1-srf08-front.jpg

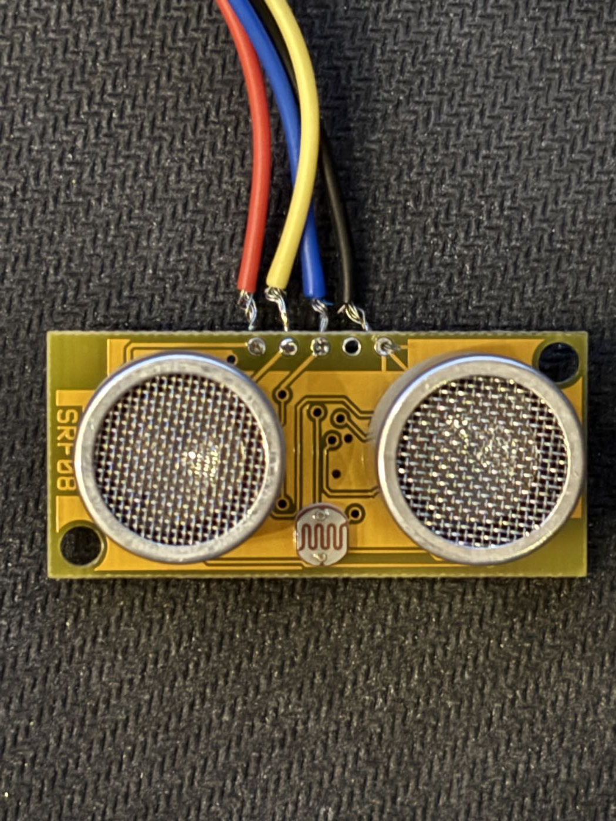
parts/photos/s1-srf08-front.jpg
