claust/robot_3d/parts/photos/s1-srf08-harness.jpg

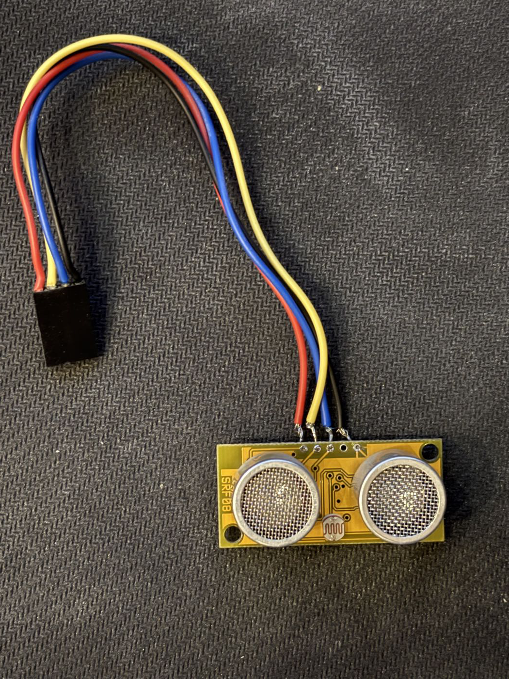
parts/photos/s1-srf08-harness.jpg
