claust/robot_3d/parts/photos/s2-ir-receiver.jpg

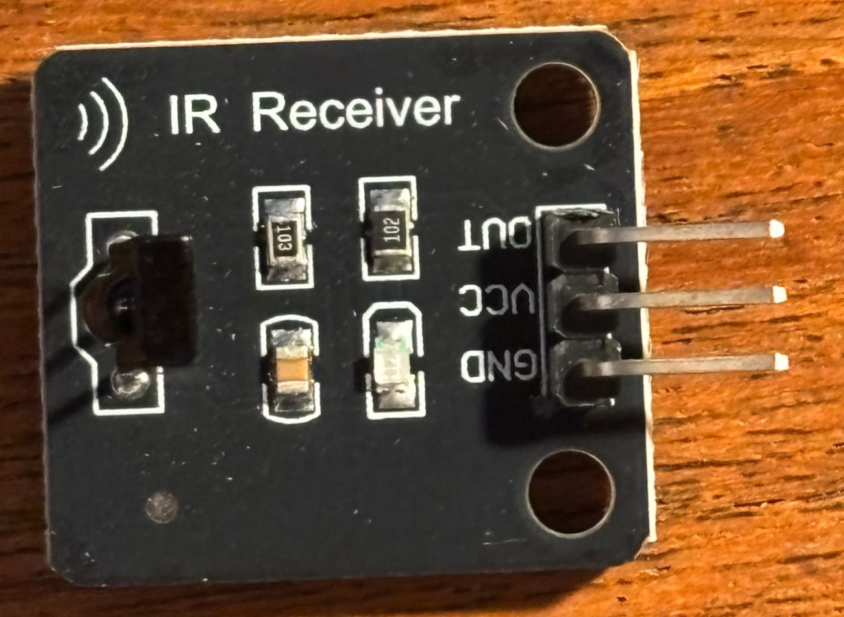
parts/photos/s2-ir-receiver.jpg
