claust/robot_3d/parts/photos/s2-ir-transmitter.jpg

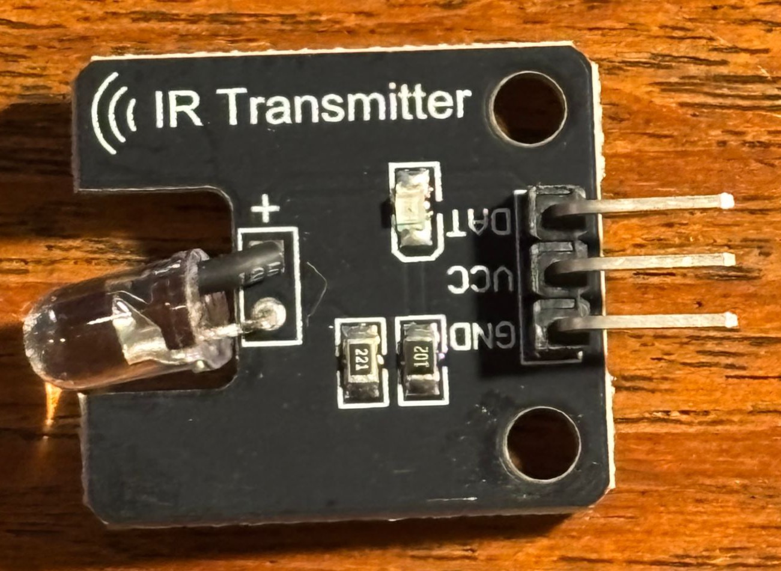
parts/photos/s2-ir-transmitter.jpg
