claust/robot_3d/(list of files, drawings)

Other design files:
cad/robot_car/robot_car.fzz
esp32-c5/blink/blink.fzz
esp32-c5/led_flash/led_flash.fzz
esp32-c5/srf08_range/srf08_range.fzz
