claust/robot_3d/(commit log)

2026-08-26 Add build123d washer demo and X2D print pipeline
    - demo_01: parametric washer (outer diameter driven) with PNG render verification
    - print_pipeline.py: headless slice via Bambu Studio CLI (with profile
    inheritance resolved locally), pre-flight gcode verification, FTPS upload,
    MQTT print start/status against the Bambu Lab X2D over LAN
    - uv-managed environment, printer credentials via gitignored .env
    - CLAUDE.md with script usage basics
2026-08-26 Add printable hex nut (demo_02) and spur gear (demo_03)
    demo_02/nut.py: parametric ISO hex nut driven by thread size string (e.g.
    M8). Body dimensions from bd_warehouse's ISO 4032 tables, real modeled
    internal ISO thread with a radial printing clearance (default 0.3 mm) so a
    steel bolt fits after FDM printing. Exports a half-section STL for
    inspecting the thread profile. Prints flat, no supports.
    demo_03/gear.py: parametric involute spur gear driven by module and tooth
    count (defaults: module 1, 20 teeth, 6 mm face width, 5 mm center bore),
    built with py_gearworks added as a local editable dependency
    (/Users/claus/Repos/py_gearworks).
    Both parts verified through print_pipeline.py and test-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
2026-08-26 Add clearance fit-test coupons (demo_04 prep)
    fit_test.py prints a tab with a 5 mm post and a washer with a
    post + 2 x clearance bore (default 0.3 mm radial) in one job, to
    calibrate running clearances for the demo_04 snap-fit gear box by feel.
2026-08-26 Set calibrated 0.2 mm default running clearance
    Coupon tests in white PLA: 0.3 mm radial was visibly sloppy, 0.2 mm
    moves freely with slight wobble — the approved running fit.
2026-08-26 Add demo_04 gear-train enclosure with automated design checks
    Three-gear train (module/teeth parametric, centers via py_gearworks
    mesh_to) on snap posts in a snap-together two-part enclosure; all parts
    print supportless. assembly_check.py runs 43 PASS/FAIL design checks:
    interference, calibrated clearances, mesh sweep, snap strain,
    sliceability incl. mesh overhang scan.
2026-08-26 Rework demo_04 into an open frame: no lid, no bottom plate
    Perimeter ring + low spine/cross arms running 1 mm under the gears to
    hub pads with the slotted snap posts; gears stay fully visible and
    touchable from top and sides. Checks updated for the frame (27 PASS).
2026-08-26 Open the frame ends so the outer gears overhang and can be rolled
    Side rails now span only between the outer hubs (ladder layout); the
    z12 and z30 gears stick out past the ends, touchable from ends and
    sides. Checks updated (27 PASS).
2026-08-26 Add macOS printer status app (macos/PrinterStatus)
    Small SwiftUI window app showing the X2D's live state over LAN MQTT:
    job/progress/layers, per-nozzle (L/R) + bed + chamber temperatures,
    AMS slots with humidity, fans, speed, and HMS alerts linked to the
    Bambu wiki. Read-only — it never sends print commands.
    Four temperature renderings (Cards, Schematic, Glow, Isometric)
    switchable in-app; Glow (dark chamber with heat-glow nozzles above
    the plate) is the default. --simulate feeds fake data through the
    real decode path, --dump prints one live status headlessly, and
    --snapshot renders the UI to PNG for verification.
    Protocol notes from a live pushall capture plus OpenBambuAPI and
    pybambu d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
2026-08-26 Narrow the ladder to 20 mm so the gear rims overhang the sides
    Rails drop to 3 mm (same as the arms) since the z20/z30 rims now pass
    over them with the 1 mm gap; the z30 overhangs each side by 6 mm and
    both open ends remain. Checks updated (27 PASS).
2026-08-26 Address Copilot review comments
    - Run --snapshot rendering as an async MainActor task instead of
    MainActor.assumeIsolated in top-level code, which could trap if the
    executor check fails; data waiting now uses Task.sleep so simulated
    reports still arrive while the render task is suspended.
    - Derive isometric temperature callouts from the actual nozzle array
    instead of assuming first=left/last=right, and center the glyph and
    hide L/R letters when the printer reports a single nozzle.
2026-08-26 Round the frame: filleted one-piece plank, wide cross arms, no hub pads
    The ladder is now a single 2D outline (rails + spine + 8 mm cross arms)
    with r1.5 fillets on every corner, extruded 3 mm. Cross arms match the
    boss diameter so bosses sit fully supported without square pads.
2026-08-26 Address Copilot round 2: TLS verification and dump-mode data race
    - Validate the printer's TLS certificate chain against Bambu's public
    device CA (vendored from Bambu Studio's printer.cer in BambuTrust.swift)
    via NIOSSL with hostname verification off — the certificate names the
    printer serial, not its IP. BAMBU_TLS_INSECURE=1 opts out. Verified
    live against the printer (accepts) and against a local openssl s_server
    with a self-signed cert (rejects with a clear status message).
    - Guard runDump's merged report dictionary with a lock and decode from a
    stable copy — reports arrive on the MQTT thread while the main thread
    waits.
    - Suppress reconnect status messages after stop()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
2026-08-26 Address Copilot round 4: lifecycle, parsing, equality, accessibility
    - Make BambuMQTTSource.start() and SimulatedSource.start() idempotent by
    stopping any existing loop first.
    - Trim newline characters in the .env parser so CRLF files work, and trim
    whitespace around keys.
    - Drop PrinterSnapshot's partial custom == in favor of the synthesized
    full-field comparison.
    - Add an accessibility label to the temperature-style palette menu.
2026-08-26 Address Copilot round 5: detached simulator loop, credential messaging
    - Run the simulated-data loop as a detached task so it doesn't inherit
    the view model's MainActor context and tick on the UI thread.
    - Mention BAMBU_* env vars alongside cad/.env in the no-credentials
    status text and Live/Simulate tooltip.
2026-08-26 Address Copilot round 6: task lifetime, snow sentinels, empty credentials
    - End the simulator loop when its source is deallocated (while let self),
    matching the MQTT source's pattern.
    - Reject snow values whose tray byte is not a real tray index (0-3) so
    sentinel encodings can't highlight a wrong AMS slot.
    - Require credentials to be non-empty, from env vars and .env alike.
2026-08-26 Address Copilot round 7: empty AMS slot rendering, PNG write check
    - Fill empty AMS slots with a neutral placeholder instead of their fully
    transparent reported color.
    - Fail --snapshot with exit 1 when CGImageDestinationFinalize reports a
    write failure.
2026-08-26 Address Copilot round 8: async client shutdown, doc wording
    - Offload MQTT client shutdown to a background queue so switching
    Live/Simulate can't block the main thread.
    - Correct the deepMerge doc comment (arrays replace, keys persist) and
    the RESEARCH.md TLS note (Bambu device CA, not self-signed).
2026-08-26 Install PrinterStatus as a Mac app launchable from Spotlight
    Replace make_app.sh with install.sh, which builds a release bundle,
    installs it to /Applications (falling back to ~/Applications) and
    registers it with Spotlight.
    An installed app can't find cad/.env by walking up from its own location,
    so credentials now also resolve from
    ~/Library/Application Support/PrinterStatus/config.env — holding either
    the BAMBU_* values directly or a BAMBU_ENV_FILE= pointer, which the
    installer writes so the secrets stay in one file. The pointer resolves to
    the main checkout's cad/.env even when installing from a git worktree.
    Also report unreachable-printer failures with a hint about macOS Local
    Netwo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
2026-08-27 Add live chamber camera and redesigned card layout to PrinterStatus
    Split the window into two columns: status, AMS, and footer on the left;
    the chamber schematic stacked over a live camera pane on the right.
    - CameraSource: the X2D serves its camera as RTSPS on port 322, which
    AVFoundation can't play, so a long-lived ffmpeg subprocess transcodes
    to 5 fps MJPEG on a pipe; frames split on JPEG SOI/EOI markers,
    auto-reconnect 3 s after a drop.
    - ChildReaper: kill spawned ffmpeg children on any normal exit or
    catchable signal — quitting used to leak an orphan that kept
    streaming from the camera (and shrugged off SIGTERM).
    - Fans drawn into the chamber schematic where they physically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
2026-08-27 Address Copilot review: MJPEG marker split, explicit socket pointers
    - CameraSource: when no SOI marker is found, keep the last two bytes
    instead of dropping the whole buffer. A marker straddling a chunk
    boundary was discarded, swallowing the following frame.
    - PrinterNameSource: pass socket buffers through withUnsafeBytes /
    withUnsafeMutableBytes / withUnsafeMutableBufferPointer rather than
    relying on implicit array-to-pointer conversion, making the pointer
    lifetimes explicit at the call sites.
2026-08-27 Keep the printer access code out of the ffmpeg argument vector
    The camera URL embeds the access code, so it was visible in `ps` output
    for the lifetime of the stream. Pass it over ffmpeg's stdin as a one-line
    concat playlist instead; the argument vector now carries no credential.
    rtsps is TLS over TCP, so the explicit -rtsp_transport flag (rejected by
    the concat demuxer) is not needed. Verified: same frame rate as before,
    and the access code no longer appears in the process arguments.
2026-08-27 SIGKILL the camera subprocess on stop, not SIGTERM
    stop() used Process.terminate(), contradicting ChildReaper's own
    rationale: ffmpeg blocked writing to a pipe we no longer drain can
    ignore SIGTERM. Switching to Simulate mode could therefore leave it
    streaming, with its pid still registered in the reaper.
    Send SIGKILL and unregister the pid immediately. Verified over three
    start/stop cycles against the live printer: each spawned ffmpeg is
    reaped on stop, leaving no orphans.
2026-08-27 Add demo_05: supports printed from the auxiliary nozzle
    Design a support-demo bracket (45-degree gusseted arm vs pure cantilever)
    plus a quick dual-nozzle coupon, and teach the print pipeline to slice and
    print body + support as two filaments on the X2D's two nozzles:
    - slice --supports loads a second filament profile, routes all support to
    it, and maps filaments to extruders via CLI args (profile-key mapping
    segfaults the Bambu Studio CLI, upstream issue #9119); the prime tower is
    parked at (180,180) inside the aux extruder's reachable area
    - slice --set KEY=VALUE allows ad-hoc process overrides
    - print --trays 2,ext maps sliced filaments to AMS slots or the external
    spool (ams_map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
2026-08-27 Port the printer status app to iOS with a TestFlight pipeline
    New ios/PrinterStatus XcodeGen project sharing the macOS app's protocol
    layer (MQTT source, snapshot decode, Bambu TLS trust, SSDP name lookup,
    simulator) unchanged, with an iPhone-native UI: one scrolling column of
    cards — status/progress, the Glow chamber schematic, AMS trays, and a
    connection footer. Credentials are entered in a settings sheet (IP and
    serial in UserDefaults, access code in the Keychain) instead of cad/.env,
    with BAMBU_* env vars still winning for simulator testing. No camera pane:
    that requires spawning ffmpeg, which iOS forbids.
    On iOS, MQTTNIO compiles NIOSSL out, and Network.framework's trust
    evaluation a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
2026-08-27 Address Copilot review: iOS-only TLS branch, env loader, launch churn
    - BambuMQTTSource: the unverified-TLS fallback is now #elseif os(iOS)
    with #error on any other platform, so a future port must choose its
    TLS posture consciously.
    - testflight.sh: replace the eval-based .testflight.env loader with
    ${!key-} indirect expansion and an identifier check, so a malformed
    env file cannot inject commands.
    - PrinterViewModel: skip the redundant restart on the launch transition
    to .active — init() already started the sources.
    - Stop committing Sources/Info.plist: it is xcodegen output; project.yml
    is the single source of truth.
2026-08-27 Surface Keychain save failures; document the iOS TLS posture
    From Copilot's third review pass (suppressed comments, no threads):
    - Keychain.setAccessCode now checks both the delete and add OSStatus and
    returns success; the settings sheet shows an alert and stays open when
    the write is refused, instead of silently losing the access code.
    - README documents that the iOS MQTT session is encrypted but not
    chain-verified, unlike macOS, and why that is the best iOS can do.
2026-08-27 Address Copilot fourth pass: Keychain class, IP keyboard, mode unstick
    - Access code stored WhenUnlockedThisDeviceOnly: out of backups and
    iCloud Keychain, readable only unlocked — the app is foreground-only.
    - IP field uses .numbersAndPunctuation: .decimalPad has no "." key in
    comma-decimal locales, making an IPv4 address untypeable.
    - Clearing credentials while in live mode now drops back to simulated,
    since the disabled mode picker would otherwise strand the user on
    "No printer configured".
2026-08-27 Address Copilot fifth pass: client id, 0% bar, atomic save
    - MQTT client identifier is platform-tagged (Mac/iOS) with a random
    suffix, so concurrent macOS and iOS sessions cannot collide and the
    broker never drops one for the other.
    - The progress bar's 10pt visibility floor no longer applies at 0%,
    matching the "0%" label.
    - PrinterConfig.save writes the Keychain first and only persists
    IP/serial on success — a failed save no longer leaves a half-updated
    config.
2026-08-27 Address Copilot sixth pass: keep old credential, stale name, TLS badge
    - Keychain.setAccessCode uses add-or-update instead of delete-then-add,
    so a refused write leaves the previously working access code intact;
    delete only happens when clearing.
    - restart() clears printerName so a stale SSDP name cannot linger as the
    title in simulate mode or after switching printers.
    - Live mode shows a footer note that the connection is encrypted but the
    printer's identity is unverified, matching the documented iOS TLS
    posture instead of implying full verification.
2026-08-27 Address Copilot seventh pass: settings validation, TLS badge gating
    - Save validates all-or-nothing: a partial printer config shows an alert
    and keeps the sheet open instead of silently landing in simulate mode;
    all-empty still clears the printer deliberately. The alert copy covers
    both validation and Keychain failures.
    - The encrypted-but-unverified footer note only shows while the live
    session is actually connected.
2026-08-28 Add parts library cataloguing the salvaged robot hardware
    An HTML inventory (parts/index.html) of equipment on hand for the robot
    platform: the two Canon CK35-H12CH-22V motors, the Devantech MD22 dual
    motor driver, the unconfirmed CM02 radio module, the vintage GP NiMH
    pack, and the two Yowoo 2S LiPo packs — each with status, specs so far,
    and bench-verification checklists. Part photos are background-removed
    and EXIF-stripped for the public repo.
    The stock Python .gitignore ignored parts/ (a buildout artifact dir);
    this repo doesn't use buildout, so the entry is dropped.
2026-08-29 Add LAN printer discovery and iOS onboarding, on a shared BambuKit package
    The iPhone app asked for the printer's IP, serial and access code as three
    hand-typed fields. Bambu printers answer a directed SSDP M-SEARCH on UDP
    1990/2021 with their serial (USN), name, model and firmware, so all but the
    access code can be discovered: sweeping the local subnet with one unicast
    probe per host finds the printer in well under a second (253 hosts, 130 ms
    to first reply on our LAN).
    The sweep is unicast rather than a listen for Bambu's own broadcast for two
    reasons: iOS gates broadcast and multicast behind the multicast entitlement,
    which Apple grants by application; and a passive listener on 2021 lose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
2026-08-29 Address review: explicit UIKit import, case-insensitive ST, O(1) dequeue
    - OnboardingView reaches UIApplication through SwiftUI's re-export today;
    import UIKit outright so it does not depend on that.
    - Match the `ST` header value case-insensitively. Header *names* were
    already normalised, but no firmware promises the casing of the value, and
    a miss there would drop a printer from the sweep.
    - Take pending datagrams off the back of the queue: removeFirst shifts the
    whole array on every send, which is O(n^2) across a sweep. The order
    hosts are probed in does not matter.
2026-08-29 Address review: clamp the host-window conversion, make discovery single-shot
    - hostAddresses(limit:) is public, so a caller's Int can exceed what UInt32
    holds; convert with `UInt32(clamping:)` instead of trapping.
    - start() claimed it was safe to call again after stop(), which was untrue:
    stop() set a flag only reset() cleared, and reset() was never called by
    anything. Drop reset(), mark the object spent on natural completion too,
    and document it as single-shot — which is how both scan buttons already
    use it, each making a fresh PrinterDiscovery.
2026-08-29 Address review: confine discovery state to the main queue, fix README
    PrinterDiscovery's callbacks already ran on the main queue, but start() and
    stop() mutated the same state wherever the caller happened to be. Both now
    hop to the main queue (inline when already there, so a tap still starts its
    scan in the same turn), which orders a stop against the callbacks instead of
    racing them. Every caller today is main-thread, so nothing changes in
    practice — but stop() is public and nothing said so.
    The package README also listed BambuTrust and SSDP as if they were surface
    area; both are internal, and the discovery row now names the public types.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
2026-08-29 Add caliper-measured CAD reference model of the Canon CK35 motor (M1)
    New cad/parts/ folder for reference models of real salvaged hardware.
    ck35_motor.py builds the CK35-H12CH-22V from digital-caliper measurements:
    Ø34.3 x 27.6 mm can, Ø2.0 double-ended shaft, cone bearing bosses on both
    faces, six front holes on a Ø25.7 bolt circle (4 x ~2.4 mm likely tapped
    4-40 per the "INCH" face stamp, 2 x Ø3.0 plain), plus rear-lid detail
    (disc capacitors, solder domes, radial wire exit) and an optional
    rear-keepout mode for assembly checks. Estimate defaults stay visible in
    the dataclass; MEASURED_DIMS records the measured overrides.
    The parts library M1 entry gets a render of the model's mountin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
2026-08-29 Split parts library into per-part pages, add M2 N20 gearmotor
    Index is now just the table; each part gets its own page (style.css
    shared) so adding hardware doesn't mean growing one giant file.
    Also catalogs the newly-arrived N20 micro gearmotors (6 V, 1:100)
    with seller photos/diagrams and the parameter-table specs for that
    variant.
2026-08-29 Add drawing-based CAD reference model of the N20 gearmotor (M2)
    cad/parts/n20_motor.py builds the N20 micro gearmotor from the seller's
    dimension diagram, in the same reference-part style as the CK35 (M1):
    10x12x9 mm gearbox with two M1.6 x 2.1 tapped holes, O4x0.7 boss,
    O3x10 D-flatted shaft (2.5 across the flat), O12 can flattened to
    10 mm x 15 long, O5x1.2 rear boss, and the solder tabs 7.3 mm apart.
    The M2 page gets a render of the model and a correction: the drawing
    puts the mounting holes 9 mm apart, not 10 mm as previously written.
    [n20_motor.py]
2026-08-29 Expand R1 (CM02 radio module) with confirmed identity and photos
    Front/back photos of the desoldered board confirm a PIC16F688-I/SO
    MCU, an Easy Radio Ltd RF module, and an LM2940CT-5.0 regulator, plus
    the DIP switch, LEDs, card-edge contacts, and antenna wire.
2026-08-29 Add D2/D3/D4 motor drivers and P1 buck converter to parts library
    D2: DRV8833 breakout (DIYUSER), 5x, 3-10V/1.5A per channel.
    D3: a second, different DRV8833 breakout (RealPoy), 2x - different
    board and pin naming than D2, same driver IC.
    D4: TB6612FNG dual motor driver, 2x - separate VCC/VM supplies,
    1.2A/channel continuous.
    P1: MP1584EN adjustable buck converter, 5x, for stepping battery
    voltage down to logic rails.
2026-08-29 Add S1 (Devantech SRF08 ultrasonic rangefinder) to parts library
    Salvaged from the same old-robot stash as the MD22 (D1) and CM02 (R1) —
    same maker, Devantech / Robot Electronics.
    Photos confirm the harness wiring against the documented 5-way pinout:
    wires on positions 1, 2, 3 and 5 with the fourth hole bare, which is the
    "do not connect" MCLR pin — so red=+5V, yellow=SDA, blue=SCL, black=0V.
2026-08-30 Add C1 (Pi Zero 2 W) to parts library, record B2 measurements, fix M2 can length
    - New C1 page: Raspberry Pi Zero 2 W as the robot-car brain — footprint,
    GPIO/power plan (P1 buck at 5.1 V into the GPIO header), verify list.
    - B2 LiPo: caliper-measured body 93.0 x 35.2 mm, 17.7-18.3 mm tapering
    height, with pointer to the new CAD reference model.
    - M2: the can is Ø12 x 15 mm (per the dimension drawing), not 26 mm; total
    ~35 mm includes the shaft and rear boss.
2026-08-30 Add CAD reference models for the robot-car electronics (C1, D2, P1, B2)
    Reference parts in the n20_motor.py style, for designing chassis mounts
    around: Pi Zero 2 W (documented footprint + envelope blocks), DRV8833
    module (with worst-case soldered-header envelope), MP1584 buck (component
    stack height documented), and the B2 LiPo (body caliper-measured
    2026-08-30; XT60 stub still estimated).
2026-08-30 demo_06: robot-car prototype 1 — chassis, O-ring wheels, dummies, assembly checks
    Two-motor differential-drive platform for the N20 gearmotors:
    - chassis.py: 130x80 plate with snap cradles for the motors (shaft exits
    through a slotted retention wall), Pi Zero 2 W standoffs, clip trays for
    the DRV8833 (3.5 mm standoff clearing its solder tails) and MP1584,
    strap-down bay for the measured B2 pack, push-in skid sockets front and
    rear, and a mirrored underside identity engraving. Includes a boolean-
    intersection overlap check across all built features, and the separate
    skid part: Ø6 tip flat, 45-degree shoulder cone, cross-slit four-prong
    snap barb at the demo_04-validated 0.15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
    [assembly.py, chassis.py, dummies.py, wheel.py, wheel_coupons.py, wheel_coupons2.py]
2026-08-30 Add print_lint.py design-time printability linter; pipeline --aux mode
    print_lint.py checks an STL in print orientation and reports risk-ranked
    findings (HIGH/MED/LOW with location and the failure each predicts):
    unsupported overhangs via downward ray-casting (sagging/spaghetti), tall-
    part-on-small-anchor knockover risk, undersized first-layer islands, and
    fused or too-close bodies. Every check corresponds to a print failure
    that actually happened while building demo_06 (flat shoulder overhang,
    standing 34 mm dummy knocked off, Ø3 skid tip detaching, a plate-layout
    bug fusing three parts into one brick). --selftest regression-checks
    synthetic versions of all of them; --strict makes HIGH fi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
2026-08-30 Fix stale docstrings flagged by review (no geometry changes)
    - chassis.py: wheel_diameter deviation note said 62 mm; the default is 59
    (wood-copy rolling diameter).
    - dummies.py: make_motor_dummy still described the abandoned rear-face-down
    print orientation; it prints lying on the can flat with a shaft fin.
    - assembly.py: mesh-distance comment claimed rtree is not installed; it is
    a project dependency now (the cKDTree approximation stays regardless).
    Comments/docstrings only — the printed PROTO-01 geometry is untouched.
    [assembly.py, chassis.py, dummies.py]
2026-08-30 print_lint: warn on stderr when the island check is skipped
    A swallowed exception in the first-layer island check silently returned
    "no islands" — a false clean result, the worst failure mode for a safety
    linter. Skips are now visible (review finding).
2026-08-30 Add C2 (Arduino Uno + breadboard plate) and L1 (8x8 LED matrix)
    C2: genuine Italian-made Uno on a starter-kit mounting plate with a
    400-point breadboard. Pre-R3 board — no SCL/SDA pair past AREF and a
    6-pin POWER header with no IOREF, so I2C is on A4/A5 and R3-pinout
    shields won't map. ATMEGA328P-PU (date code 1016) + MEGA8U2 USB bridge.
    C1 is the Pi Zero 2 W, so this is the 5 V bench rig, not the brain.
    L1: GYXM-1388ASRG2 8x8 dot matrix. Measured 32 x 32 x 8 mm on 1 mm
    corner standoffs, 13.5 mm overall; 12 pins per row / 24 total, which
    makes it red/green bi-color rather than a 16-pin single-color part.
    Part-number size and the A/B common-anode letter are both flagged as
    untrustworthy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
2026-08-31 Add demo_07 fidget gearbox with sliding, detented small gear (#13)
    demo_04's three-gear train with the z12 on a one-piece carriage that
    slides 4 mm along the gear line and clicks between engaged and
    disengaged. The frame tail is an open two-rail fork; the carriage
    threads on from the tail end, its walls wrapping the rail outer edges
    and a pedestal rising through the rail gap so all gears stay at the
    original height. Detents are spring fingers in the carriage plate whose
    bumps click into through-holes in the rails; the deck face is a 0.1 mm
    over-travel stop, so the mesh can never be jammed tighter than the
    mesh_to distance. The z30 gets three finger divots for cranking it.
    assembly_check.py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
2026-09-01 PrinterStatus: cut the SwiftUI observation leak that got the app jetsammed (#14)
    macOS was killing PrinterStatus with jetsam out-of-memory events — recorded
    peak 45 GB on a 16 GB machine (JetsamEvent-2026-08-30-01*.ips). Live heap
    diffs against a running instance found two feedback paths driving it, both
    fixed here:
    * `.navigationTitle(model.printerName)` sat on the Scene body, so every
    published change invalidated the whole app graph and made SwiftUI rebuild
    the main menu, re-parsing SF Symbol SVGs each time. `@StateObject` on the
    App subscribed the Scene body to the model for the same reason. The model
    now lives in `AppModel.shared`, which the Scene body never reads, and the
    w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
2026-09-01 demo_07: bigger face features on z30, one raised into a knob (#15)
    The three fingertip divots in the big gear's top face grow from Ø6.5 to
    Ø8.2 (Ø9.5 counting the rim round-over) and now span nearly bore to tooth
    root, and one of the three is inverted into a raised dome knob to spin the
    gear by.
    - two dishes: R5.2 spherical cap, 2.0 deep, 0.5 rim round-over
    - one knob: R5.0 dome, 2.6 proud of the face, 0.8 concave blend
    - both blends are tangent to the face, so there is no edge to feel
    Everything still faces upward — the dome is steepest at its base (28.7 deg
    off vertical) and only flattens going up — so the gear keeps printing flat
    and supportless: 0.00 mm^2 overhang.
    assembly_che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
2026-09-01 Decode the chamber camera in-process; give iOS a live view (#16)
    * Decode the chamber camera in-process; give iOS a live view
    The macOS camera pane shelled out to a long-lived ffmpeg subprocess to
    transcode the printer's RTSPS stream to MJPEG. That works on a Mac and
    cannot work at all on iOS, which is why the phone app had no camera.
    Replace it with an in-process client in BambuKit, shared by both apps:
    RTSPS -> RTP over the same TLS socket -> H.264 -> VideoToolbox. It emits
    CGImage rather than NSImage/UIImage, so one source serves AppKit and
    UIKit, and the ffmpeg prerequisite (plus ChildReaper) is gone.
    Nothing off the shelf covers this: Apple ships no RTSP support, FFmpegKit
    was retire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
2026-09-02 robot_car (was demo_06): PROTO-02 chassis, and fix four defects the print found
    Promotes demo_06 to a named folder now that it is an ongoing build rather
    than an experiment, and lands the PROTO-02 revision. Every change below
    came from a physical failure on a printed plate, and each one also gained
    the check that would have caught it.
    Plate 80 -> 94 mm wide. At 80 the N20 body reached |Y|=14.00 and its rear
    solder tabs |Y|=11.50, both inside the pack's 17.60 mm half-width, so the
    battery sat on the motor cans -- 397 mm^3 of interference per motor. No
    check compared a motor BODY to the battery, only cradles, so the motors
    are now entries in build()'s footprints dict.
    PCB trays are tilt-and-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
    [assembly.py, chassis.py, dummies.py, render_assembly.py, twin.py, wheel.py, wheel_coupons.py]
2026-09-02 robot_car: port the spoked wheel and calibrated D-bore from 03f8c30
    Brings the new wheel design across from claude/wheel-axle-hole-design-1ec312
    (03f8c30, developed in a separate session against demo_06) into the renamed
    robot_car folder. Our wheel.py was byte-identical to master, so it is a
    straight replacement; the assembly.py diff would not apply against this
    branch's diverged copy, so its 11 hunks were applied by hand.
    D-bore calibrated on the printer rather than derived: bore_coupons.py swept
    0.00-0.20 mm radial clearance in PLA Basic, and 0.10 mm was a firm no-play
    press fit while 0.15 and up dropped on loose. Against the measured shaft
    (Ø3.0, flat 2.45 across) that gives bore Ø3.20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
    [assembly.py, bore_coupons.py, wheel.py, wheel_coupons.py, wheel_coupons2.py]
2026-09-03 Document the D2 driver wiring: motors, Pi Zero 2 W, power tree
    Adds cad/robot_car/WIRING.md: the pin-by-pin plan for the prototype
    drivetrain (B2 pack -> two P1 bucks -> C1 Pi Zero 2 W + D2 DRV8833 ->
    two M2 N20 gearmotors), the DRV8833 bridge/PWM logic tables, and a
    bring-up order that starts on a bench supply with no battery in the loop.
    Facts pinned down while writing it, from the TI DRV8833 datasheet
    (SLVSAR1E) and a photo of one of our boards:
    - ULT/EEP look like clipped silkscreen -- (FA)ULT and (SL)EEP -- which
    is the reverse of the seller's listing. The en/sleep jumpers sitting
    against EEP and the board's 47k resistor (TI's recommended 20-75k
    nSLEEP pullup) both favour the cl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
2026-09-03 C1: photo of the Pi Zero 2 W, and how to find the header pins on it
    The GPIO header question in the to-verify list is answered by the board
    photo: it is populated, 2 x 20 on 2.54 mm pitch, so the driver ribbon
    plugs straight on and only D2 needs soldering. What the top-down photo
    cannot settle is female sockets vs male pins soldered downward - both
    read as black wells with a recessed contact - so that becomes the sharper
    open item, since it decides which end the jumper wires need.
    Also from the photo: the RP3A0-AU marking (so the 2 W, not the original
    Zero), a microSD card already fitted, and the USB / PWR IN silkscreen on
    the two otherwise identical micro-USB jacks - named now in bring-up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
2026-09-03 Settle the header question: male pins both ends, female-female leads
    The Pi's 40-pin header is male, checked on the board edge-on, so the five
    wires to D2 are plain female-female jumper leads with nothing to crimp or
    solder. Closes the open item on c1.html.
    D2's own headers ship as one 12-way strip to snap in half, not two 6-pin
    strips - and with no spare pin, so practice goes on scrap. Bring-up step 1
    now says how to solder them: long pins down so the module plugs into the C2
    breadboard, that breadboard as the jig, tack one pin per strip and check
    square before the rest, and what to check afterwards.
    Row spacing is 12.7 mm by inference (the only 2.54 mm multiple that fits
    across a 16 mm b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
2026-09-03 WIRING.md: the pack harness and what wire each run wants
    The power section went straight from the XT60 to bare buck pads with nothing
    in between. Fill that in: an XT60 pigtail (gender goes by the metal, not the
    housing, which is where the confusion comes from), a 2 A fuse at the pack, a
    5 A switch so the connector is not the on/off control, and a lever connector
    or terminal for the fan-out to two bucks. Only the buck input pads get
    soldered.
    The fuse is the point of the section: worst-case draw is ~1.1 A, but a
    2200 mAh 2S pack feeds a short with tens of amps - which is also what sets
    the wire gauge on the battery side, not the running current. Table of what
    each run wants, from 20 AWG sili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
2026-09-06 Round and raise the snap post slit root, in both gearboxes (#20)
    The frame's z30 snap post has now broken twice at the slit root, once at
    the stock 2 walls / 15 % infill and once at 4 walls / 50 % — the beefier
    slice bought some life but did not fix the cause. The cause is geometric:
    the slit bottomed out in a square-cornered notch at z=5.2, only 2.2 mm
    above the post base, right where a crank load's bending moment is largest.
    Two changes to post_with_lip, in demo_07 and in demo_04, which build the
    identical post:
    - the slit root is now a full semicircle (a cross-axis cylinder of radius
    SLIT_W/2 under the box cut) rather than a square corner, dropping the
    stress concentration factor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
2026-09-19 Add ESP32-C5 blink firmware and VS Code setup (#22)
    * Add ESP32-C5 blink firmware and the VS Code setup around it
    First ESP-IDF project for the Seeed XIAO ESP32-C5: blinks the user LED
    (GPIO 27, active-low) and reports each toggle on the USB Serial/JTAG
    console. sdkconfig.defaults pins the target, the USB console and the
    board's real 8 MB flash, so a fresh checkout builds without set-target.
    VS Code: a multi-root workspace lists the firmware folder before the
    repo root, because the ESP-IDF extension only builds a workspace folder
    and treats the first as active. cpptools reads the build's
    compile_commands.json with a Linux IntelliSense mode; a macOS mode
    defines __APPLE__ and esp_attr.h the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
2026-09-19 parts: add C3, the XIAO ESP32-C5 (×2) (#23)
    Documents the two XIAO ESP32-C5 boards: what's confirmed on our own
    hardware (8 MB flash from esptool flash-id, user LED on GPIO 27
    active-low, console over the chip's USB Serial/JTAG), what comes from
    Seeed's spec and still needs checking (PSRAM, the D0-D10 to GPIO map,
    deep-sleep current), and how it fits next to the Pi Zero 2 W: 3.3 V
    logic that drives the DRV8833 directly, real hardware PWM where the Pi
    has none, and no 5 V I2C without a shifter.
    Includes the underside-pad notes -- B+/B-, JTAG and A1-A4 are bare SMD
    pads, so the section covers how to solder to them without lifting one,
    and why B+ is a battery node rather than a supply input.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
2026-09-19 Add ESP32-C5 led_flash project and tighten CLAUDE.md (#24)
    * Add ESP32-C5 led_flash project and tighten CLAUDE.md
    led_flash flashes an external LED on pad D0 (GPIO 1, active-high,
    330 ohm to GND) from its own FreeRTOS task. CLAUDE.md drops the
    per-project listing and detail already covered by READMEs and code.
    * led_flash: note stack units and report a failed task create
    ESP-IDF's xTaskCreate takes the stack size in bytes, unlike vanilla
    FreeRTOS, so 2048 is 2 KB.
    ---------
    [led_flash_main.c]
2026-09-19 Add fritzing-format skill for scripting Fritzing sketches (#21)
    * Add fritzing-format skill: .fzz/.fz sketch format and reload procedure
    Reference for generating and editing Fritzing sketches from scripts,
    verified against the local Fritzing 1.0.8 build: XML schema table,
    parts.db lookups, connector coordinate math, and how to get Fritzing
    to show an external edit (no file watching; quit+relaunch, open -a,
    or headless -svg export). Includes a stdlib-only helper (fzz.py) and
    three example scripts (new sketch, edit property, add wire).
    * fzz.py: drop stale .fz members, keep explicit index 0, reject built-in parts
    Addresses the Copilot r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
2026-09-19 esp32-c5: Fritzing schematics for blink and led_flash (#27)
    * esp32-c5: Fritzing schematics for blink and led_flash
    Each project now keeps its circuit as a Fritzing sketch (<project>.fzz,
    the source, edited with the fritzing-format skill or in Fritzing) plus a
    rendered <project>_schematic.png for viewing on GitHub. Breadboard and
    PCB renders stay ignored.
    - blink: the on-board USER LED circuit from Seeed's XIAO ESP32-C5
    schematic (rev V1.1): 3V3 -> R13 1.5k -> D3 yellow -> GPIO27, so the
    LED is active-low.
    - led_flash: D0 -> red LED -> 330 ohm -> GND.
    Both sketches bundle Seeed's XIAO ESP32C5 part, so they open without
    importing it. The .fzpz itself goes in esp32-c5/fritzing-parts/ fo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
    [blink.fzz, led_flash.fzz]
2026-09-19 fritzing-format: fix connector geometry, support .fzpz parts (#26)
    * fritzing-format: fix connector geometry, support .fzpz parts
    fzz.py bug fixes:
    - Bendable legs: the free end is the leg endpoint farther from the SVG
    centre (FSvgRenderer::calcLeg), not always x1,y1. The 5 mm LED's wires
    landed mid-leg.
    - Use the terminalId element (schematic pin end, where Fritzing attaches
    wires) before svgId, and measure groups and <path> shapes instead of
    raising.
    - Apply SVG transforms on the element and its ancestors.
    Checked against the 44 sketches in sketches/core: 94.7% of 1,492 saved
    wire ends match connector_pos within 0.5 px (was 41.4%).
    New helpers: load_fzpz (register a vendor part;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
2026-09-19 Add shared pwm_led component and led_fade example (#25)
    * Add shared pwm_led component and led_fade example
    esp32-c5/components/pwm_led wraps the LEDC peripheral behind a
    percent-brightness API: pwm_led_new, set, fade, and breathe/stop, which
    run the up/down fade from a background task. Gamma correction is a
    per-LED option, done in hardware with the C5's multi-segment fade.
    Projects pull it in with EXTRA_COMPONENT_DIRS ../components.
    pwm_led_stop asks the breathing task to exit, not deleting it: a
    WAIT_DONE fade holds an LEDC driver mutex that task deletion would leak.
    led_fade breathes the D0 LED through it. Every project's VS Code
    settings now pin IDF_TARGET=esp32c5 — without it the E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
    [led_fade_main.c, pwm_led.c, pwm_led.h]
2026-09-26 Add esp32-c5/srf08_range and retire S1 (#28)
    * Add esp32-c5/srf08_range and retire S1
    Bring up the Devantech SRF08 (parts library S1) on the XIAO ESP32-C5 over
    I2C, and record what the bench test found.
    The firmware scans the bus, adopts the first device in the SRF08's address
    range, reads the revision register as a liveness check, then pings 4x a
    second and prints the light level plus every echo. The scan covers
    0x03-0x7F rather than the usual 0x08-0x77, because the SRF08's 16 possible
    addresses (0x70-0x7F as 7-bit) run into the I2C reserved block at 0x78.
    S1 turned out to have no I2C pull-ups of its own, measured before powering
    anything, so the bus idles at whatever we pull it up to an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
    [srf08_range.fzz]
2026-09-26 parts: record first motor test (B2, P1, D2, M2 now ok) (#29)
    One pack -> 10 A fuse -> P1 buck -> D2 bridge A -> one M2, IN1 pulled
    high through 10 kOhm: the motor ran and reversed via IN2. This settles
    two D2 open points (VCC doubles as motor supply; the factory-bridged en
    jumper keeps the chip awake). B2 gets a voltage reading (8.45 V, full)
    rather than a test note.
2026-09-26 parts: XIAO ESP32-C5 pinouts, pinout.xyz link for the Pi (#31)
    * parts: XIAO ESP32-C5 pinouts on C3, pinout.xyz link for the Pi (C1)
    C3 gets Seeed's front and back pinout diagrams (cropped, 2400 px wide).
    The front one fills in D10 = GPIO10 (SPI MOSI), the SPI roles of D8/D9,
    A0 on D0, the low-power D0/D1 and BOOT on GPIO28. The back one corrects
    the underside pad list -- JTAG (MTDO, MTDI, MTCK, MTMS), GND, EN, 3V3,
    BOOT and BAT+/BAT-, no A1-A4 -- and gives the battery-voltage read:
    GPIO26 high enables it, GPIO6 on the ADC, times 2.
    C1 and its index row link to pinout.xyz for the 40-pin header.
    * Update link to pinout.xyz in c1.html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
2026-09-26 robot_car: snug DRV8833 tray, sturdier latch, slide-on motor lids (#30)
    * robot_car: slide-on motor lid coupon for PROTO-03, and its 3D twin
    PROTO-02's lip-finger cradle let the N20 pop out. lid_coupons.py tries a
    separately printed lid instead: dovetail rails outside the cradle walls,
    a lid whose hooks slide under them from inboard toward the wheel, a pad
    that preloads the motor top, and a skirt-tip detent that snaps into a
    recess in each rail. The lid stops short of the can's rear face so the
    solder tabs and wires stay free. PASS/FAIL checks cover slide clearance,
    pad-only motor contact, detent ride and the pad's lead-in over the can rim.
    Two printed rounds settled the fit at 0.10 mm rai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
    [assembly.py, chassis.py, d2_drv8833.py, drv_coupons.py, lid_coupons.py, lid_twin.py, render_assembly.py, twin.py]
2026-09-26 robot_car: second buck tray for the motor rail, PROTO-03 engraving (#32)
    WIRING.md powers the Pi and the motor driver from separate P1 bucks (5.1 V
    and 6.0 V) so a motor stall can't pull down the Pi's supply, but the
    chassis had only one buck tray. The second is a mirror image of the Pi's,
    on the left beside the battery (motor_buck_y = +27.8), the same side as
    the DRV8833, with its own zip-tie hole. The right side had no room for
    both (51.5 of 52 mm, or 25.0 of 25.0 mm turned).
    assembly.py places and checks both buck boards: 24/24 PASS. chassis.py
    overlap and connectivity checks PASS. The underside engraving now reads
    PROTO-03.
    [assembly.py, chassis.py, render_assembly.py]
2026-09-26 robot_car: design overview README (#33)
    * robot_car: design overview README
    The car's design was spread over the chassis docstring, WIRING.md, the
    parts library and a dozen script headers, and the cad README didn't
    mention robot_car at all. cad/robot_car/README.md is the map: the bought
    parts and their test status, the printed parts and the script that makes
    each, how the car holds together and the one assembly-order constraint
    (motor lids before the battery), the fits settled on the printer with the
    field that owns each value, the pre-print checks, the PROTO-01..03 history
    and where the details live.
    cad/README.md and CLAUDE.md point to it.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
2026-09-26 robot_car: PROTO-04 -- power switch well, header-friendly buck trays (#34)
    * robot_car: PROTO-04 -- power switch well, header-friendly buck trays
    Power switch: cad/parts/kcd1_rocker.py models the KCD1-style mini rocker
    from the user's caliper numbers (factory-bent terminals, arc snap clips
    on the short ends). switch_well.py owns the snap-in well -- a raised
    panel with the 19.0 x 13.0 cutout on two end walls, long sides open --
    plus a pose-grid motion search proving the bent terminals can be put in
    past the panel and their neighbours, and the fit coupon (panel C, 3.0 mm,
    fit best). chassis.py builds it on the left between the motor cradle
    and the motor buck.
    Buck trays: the X-capture pcb_tr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
    [assembly.py, buck_coupons.py, chassis.py, drv_coupons.py, dummies.py, kcd1_rocker.py, p1_mp1584.py, render_assembly.py]
2026-09-27 robot_car: nose swivel caster, first iteration (#35)
    * robot_car: swivel caster on a nose arm, in place of the front skid
    A Ø40 caster wheel on a 10 mm trail. It is taller than the 20.5 mm under
    the plate, so it swivels out ahead of the nose on an arm: the pivot sits
    38.8 mm past the nose, where the wheel's 30.3 mm swing circle clears the
    arm's leg by 3.3 mm.
    Six printed pieces, one green plate (41 min, 14.1 g):
    - arm, printed on its side so the loads run along the layers; its foot is
    clamped under the plate by an anchor rivet (the skid's barb, hollow)
    through the existing front skid hole, so PROTO-04 needs no change
    - fork, printed crown down; the crown top is the thrust face
    - two i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
2026-10-03 robot_car: wiring schematic, Pi ground at buck #2, working links, single-turn trimpot (#36)
    * robot_car: WIRING.md -- Pi ground at buck #2, working links, single-turn trimpot
    Route the Pi's signal ground (header pin 34) to P1 #2's second OUT- pad
    instead of D2's GND pin. D2 has a single GND pin, so two Dupont sockets
    can't share it; the P1 has two OUT- pads on the same copper. A new
    Grounds section explains the two ground wires and why the Pi ground runs
    in the signal ribbon. It also says D2's buck ground is now its only
    ground: if that wire comes loose, D2 returns current through IN1-IN4 into
    the Pi's GPIOs. So solder it at the buck and use a 2-pin VCC/GND housing
    at D2.
    The doc wrote pat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
    [robot_car.fzz]
2026-10-03 robot_car: first power-up on the pack, Pi motor test script (#37)
    * robot_car: first power-up on the pack, Pi motor test script
    The whole drivetrain has run from the B2 pack: fuse, switch, both P1
    bucks (5.1 V Pi, 6.0 V driver, set unloaded and re-measured at the lead
    ends), the Pi on header pins 2/6 and the DRV8833 driving both N20s from
    the Pi's GPIOs. vcgencmd get_throttled stayed 0x0 the whole time, motors
    running included, so the separate motor rail keeps the Pi's supply clean.
    pi/robot_car/motor_test.py is the bring-up script: direction sequence,
    0-100 % creep ramp, a 100 % hold for the stall ground check, and a pin
    check. It uses gpiozero on the lgpio backend because Raspberry Pi OS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
    [motor_test.py]
2026-10-03 parts: add S2, the 38 kHz IR transmitter + receiver pair (#39)
    New page for the AliExpress VS1838 / KY-005-style IR pair, with photos
    of both boards. Board outline and mounting holes are calipered:
    23.6 x 21 x 1.6 mm, 3.2 mm holes 15.0 mm apart, centers 3.1 mm in from
    the edges.
    The receiver's OUT is pulled up to VCC, so it runs from 3.3 V when wired
    to the Pi or the XIAO. The transmitter has no driver transistor; DAT
    drives the IR LED through 220 ohm, so range from a 3.3 V pin is short.
2026-10-04 robot_car: XT60 holder on the right motor lid (#41)
2026-10-11 robot_car: PROTO-05 -- bought swivel caster in a slide-in pocket (#40)
    * robot_car: PROTO-05 -- bought swivel caster in a slide-in pocket
    The front of the car now rides on a bought swivel caster in place of the
    skid and the printed caster. Its square steel plate slides into a pocket
    in the chassis underside from the nose. There are no bolts: the fit holds
    it.
    Caster, measured by hand (parts/swivel_caster.py): plate 40.2 mm across
    the middle of each side, 1.5 thick, top face flat (rivet flush), holes
    Ø5.3 at 29.2 centre to centre (23.9 between near edges), bearing ring
    about Ø30 under the plate, wheel Ø24.7, 34 mm from the floor to the
    plate top. Trail, wheel width and fork shape are sti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
2026-10-11 robot_car: preset square, circle and eight in the iPhone remote (#42)
    * robot_car: preset square, circle and eight in the iPhone remote
    Three buttons above the thumbstick drive a 40 cm square (left turns on
    the spot), a 40 cm circle and an eight of two 40 cm loops, each ending
    where it started. The phone plays them as timed wheel commands over the
    existing 20 Hz stream, so the Pi and the protocol are unchanged and the
    300 ms watchdog still stops a car that loses its phone.
    CarLink.drive(_:) plays a pattern until it ends, Stop is tapped, the
    stick moves off centre, or the link drops; a reconnect never resumes it.
    Steps run to deadlines counted from the start, so a late wake-up doesn't
    push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
2026-10-18 robot_car: PROTO-06 groundwork -- mower spindle, Canon mount, 4WD layout (#43)
    The car becomes a small test mower: a cutter spindle in the middle,
    four-wheel drive on Ø80 lawn wheels, no caster. Nothing here is in
    chassis.py yet.
    Spindle (spindle_coupons.py, parts/bearing_6000.py): two 6000 bearings
    (10 x 26 x 8, calipered) in one printed tower, so both seats line up,
    and a printed rotor with an Ø80 disc, held by a filament cross pin.
    Coupons settled the fits, all radial:
    - bearing seat 0.05 (ring B tight; 0.00-0.15 tested)
    - axle 0.00 inside the lower bearing (pin A, a tight push) and 0.015
    above it (pin E) so it slides through; 0.05 and up rattle
    Canon motor (M1), first run from a bu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
2026-10-20 robot_car: PROTO-06 chassis -- tower built in, TB6612 tray, cone-roofed cap (#44)
    * robot_car: PROTO-06 groundwork -- mower spindle, Canon mount, 4WD layout
    above it (pin E)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
2026-10-31 BambuKit: redial the chamber camera when its stream stalls (#45)
    * BambuKit: redial the chamber camera when its stream stalls
    A connection that dies without a FIN or an error left frames() waiting
    forever, freezing the live view. Each connection now runs under a
    watchdog that tears it down and redials after 15 s of silence.
    * BambuKit: refuse sessions from a retired camera attempt
    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
2026-10-31 BambuKit: redial the camera when another viewer takes the stream (#46)
    The printer serves one camera client at a time. When another viewer
    connects, it stops our video but keeps the connection open and its RTCP
    sender reports flowing. Those reports reset the stall watchdog, so the
    view froze for good. Only video frames now count as progress.
    Also stop deciding to quit by the error's type: run() returns only when
    our own task is cancelled, and a stray CancellationError from the worker
    is reported as a dropped stream and redialed.
2026-10-31 robot_car: PROTO-06 rearranged -- power block on the plate, drivers forward (#47)
    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
2026-10-31 robot_car: PROTO-06 lid order in the README (#48)
    The front-left lid goes on before the DRV8833 board; the rear-left lid
    squeezes past the power block. Both checked on the printed chassis.
2026-11-01 robot_car: mirrored chevron wheels for the right side (#49)
    The wheels on the car's two sides face opposite ways, so a chevron
    wheel mounted on the right points its V the other way to the left's.
    light_wheel.py gets mirrored() and VARIANTS["B-mirror"], chevron B's
    mirror image (bar lean and spoke sweep negated; the D-bore is symmetric
    about its flat, so it fits the same shaft). With B on the left and
    B-mirror on the right, every V points forward at the top of its wheel.
    proto06.py mounts them that way (all checks pass), and --plate can lay
    out two copies of one variant: two B-mirror wheels are printing in dark
    blue (1 h 14 min, 18 g).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
2026-11-07 robot_car: cutter disc with clip-on razor blades (#52)
    blade_disc.py is the cutter's rotor: an Ø80 x 3 disc with pegs for two
    double-edge razor blades that press on without screws, and three filament
    pin holes that lower the disc by 0, 6 or 12 mm. parts/de_blade.py models the
    blade from IS 7371 and caliper measurements. The peg lips reach 0.20 mm past
    the hole's edge, settled on printed coupons.
    The blades reach r 58.45, so PROTO-06's tip check and render use that.
